vojt444/picoballoon/HW/picoballoon_v2/3D/SQ2337CES-T1_GE3.stp

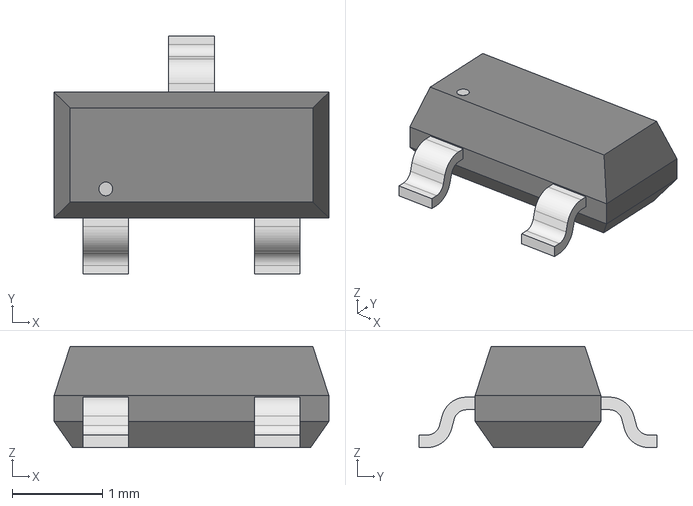
[picture p1: CAD file, 2025-04-12]
HW/picoballoon_v2/3D/SQ2337CES-T1_GE3.stp
3.05 x 2.64 x 1.12 mm
