vojt444/picoballoon/HW/picoballoon_v2/3D/CONMHF1-SMD-G-T.stp

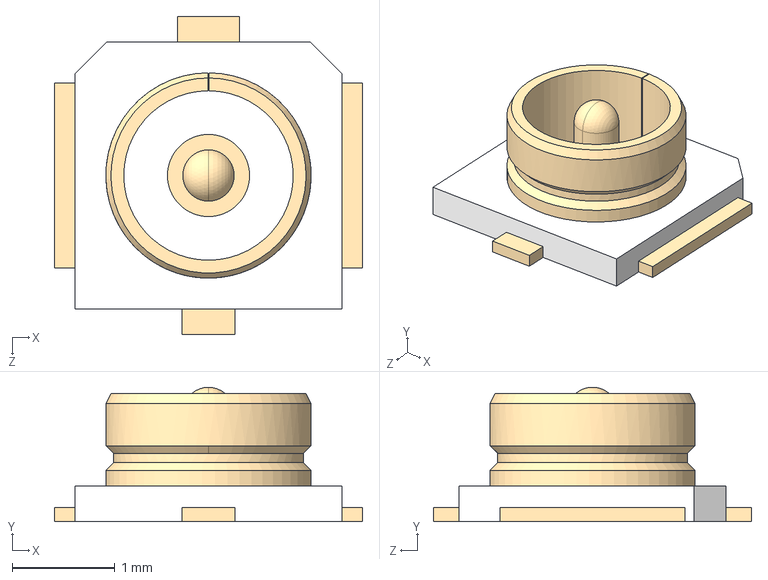
[picture p2: CAD file, 2025-04-12]
HW/picoballoon_v2/3D/CONMHF1-SMD-G-T.stp
3.00 x 1.31 x 3.10 mm
