vojt444/picoballoon/HW/picoballoon_v2/3D/RECE.20369.001E.01.stp

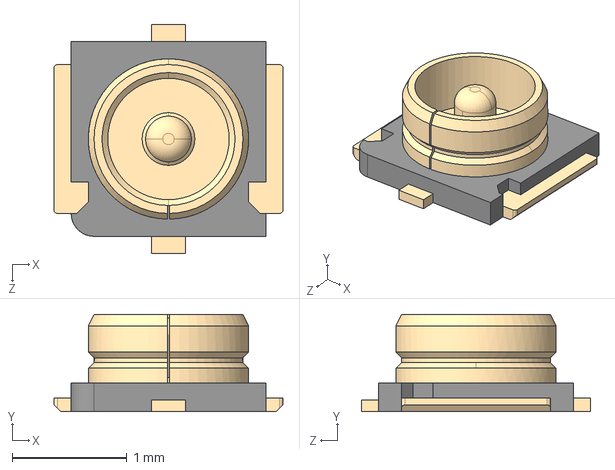
[picture p3: CAD file, 2024-12-13]
HW/picoballoon_v2/3D/RECE.20369.001E.01.stp
2.00 x 0.85 x 2.00 mm
