vojt444/picoballoon/HW/picoballoon_v2/3D/BLM21AG601SH1D.stp

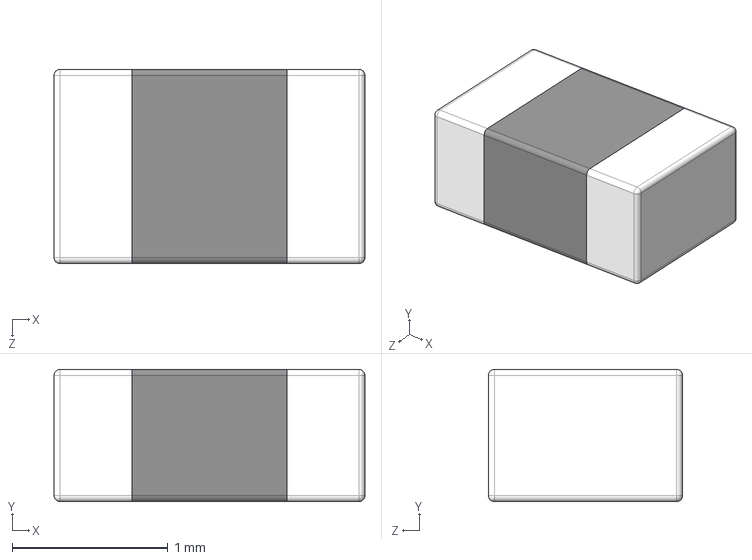
[picture p4: CAD file, 2024-12-07]
HW/picoballoon_v2/3D/BLM21AG601SH1D.stp
2.00 x 0.85 x 1.25 mm
