vojt444/picoballoon/HW/picoballoon_v2/3D/Si4461-C2A-GMR.stp

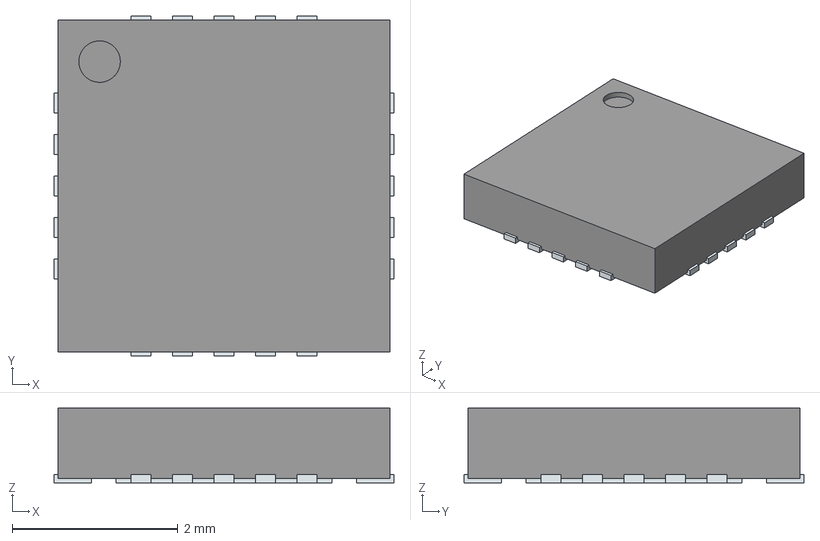
[picture p5: CAD file, 2024-12-07]
HW/picoballoon_v2/3D/Si4461-C2A-GMR.stp
4.10 x 4.10 x 0.9 mm
ThermalPin
PinsArrayLR
PinsArrayTB
