vojt444/picoballoon/HW/picoballoon_v2/3D/HTU21D.stp

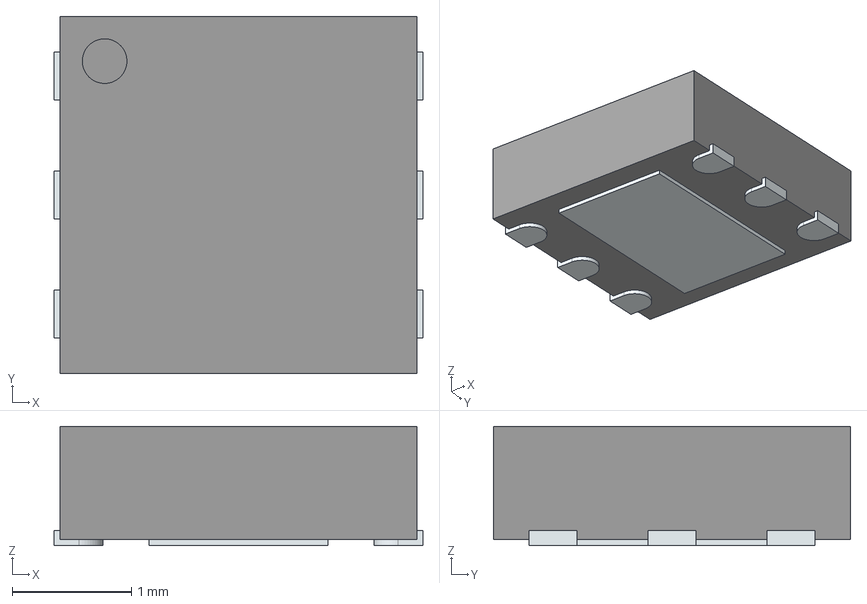
[picture p6: CAD file, 2024-12-07]
HW/picoballoon_v2/3D/HTU21D.stp
3.10 x 3.00 x 1.00 mm
ThermalPin
PinsArrayLR
