vojt444/picoballoon/HW/picoballoon_v2/3D/MPL3115A2ST1.stp

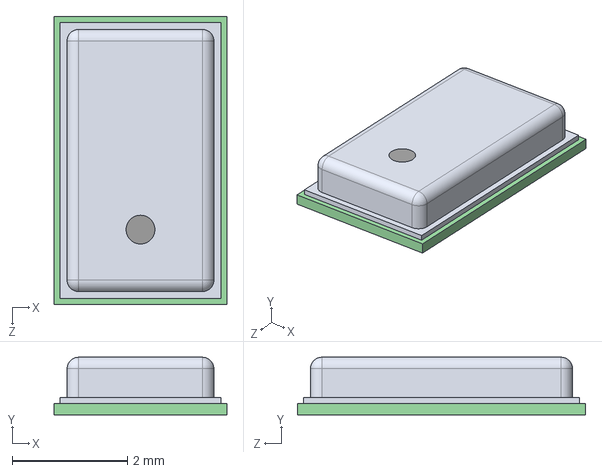
[picture p7: CAD file, 2024-12-07]
HW/picoballoon_v2/3D/MPL3115A2ST1.stp
3.00 x 1.00 x 5.00 mm
