vojt444/picoballoon/HW/picoballoon_v2/3D/MAX-M10M-00B.stp

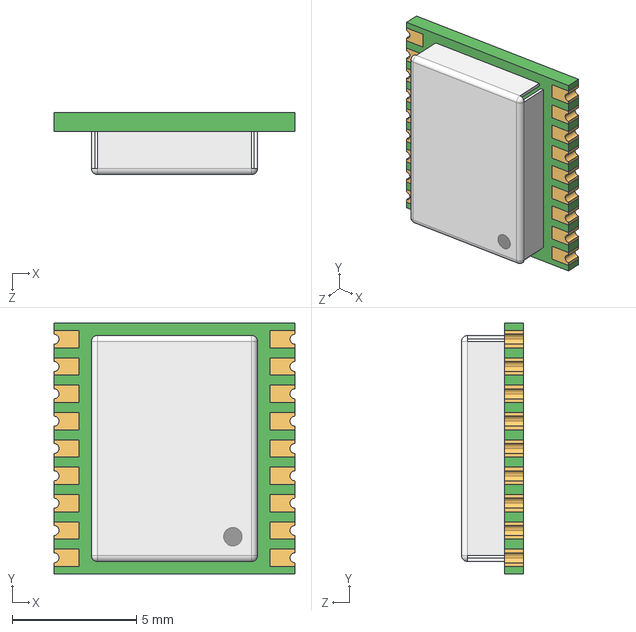
[picture p8: CAD file, 2024-12-07]
HW/picoballoon_v2/3D/MAX-M10M-00B.stp
9.70 x 10.1 x 2.50 mm
