vojt444/picoballoon/HW/picoballoon_v2/3D/TPS61097A-33DBVR.stp

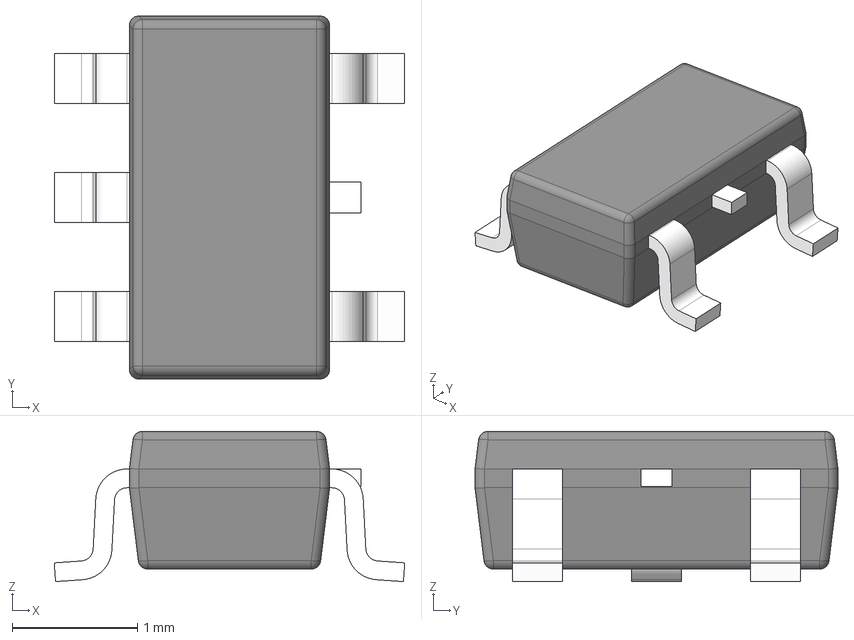
[picture p9: CAD file, 2024-12-07]
HW/picoballoon_v2/3D/TPS61097A-33DBVR.stp
2.80 x 2.90 x 1.20 mm
BODY-SOT
LEAD-SOT x 5
LEAD-DUMMY
