vojt444/picoballoon/HW/picoballoon_v2/picoballoon.kicad_pcb

## KiCad design HW/picoballoon_v2/picoballoon.kicad_pcb (2025-04-29)

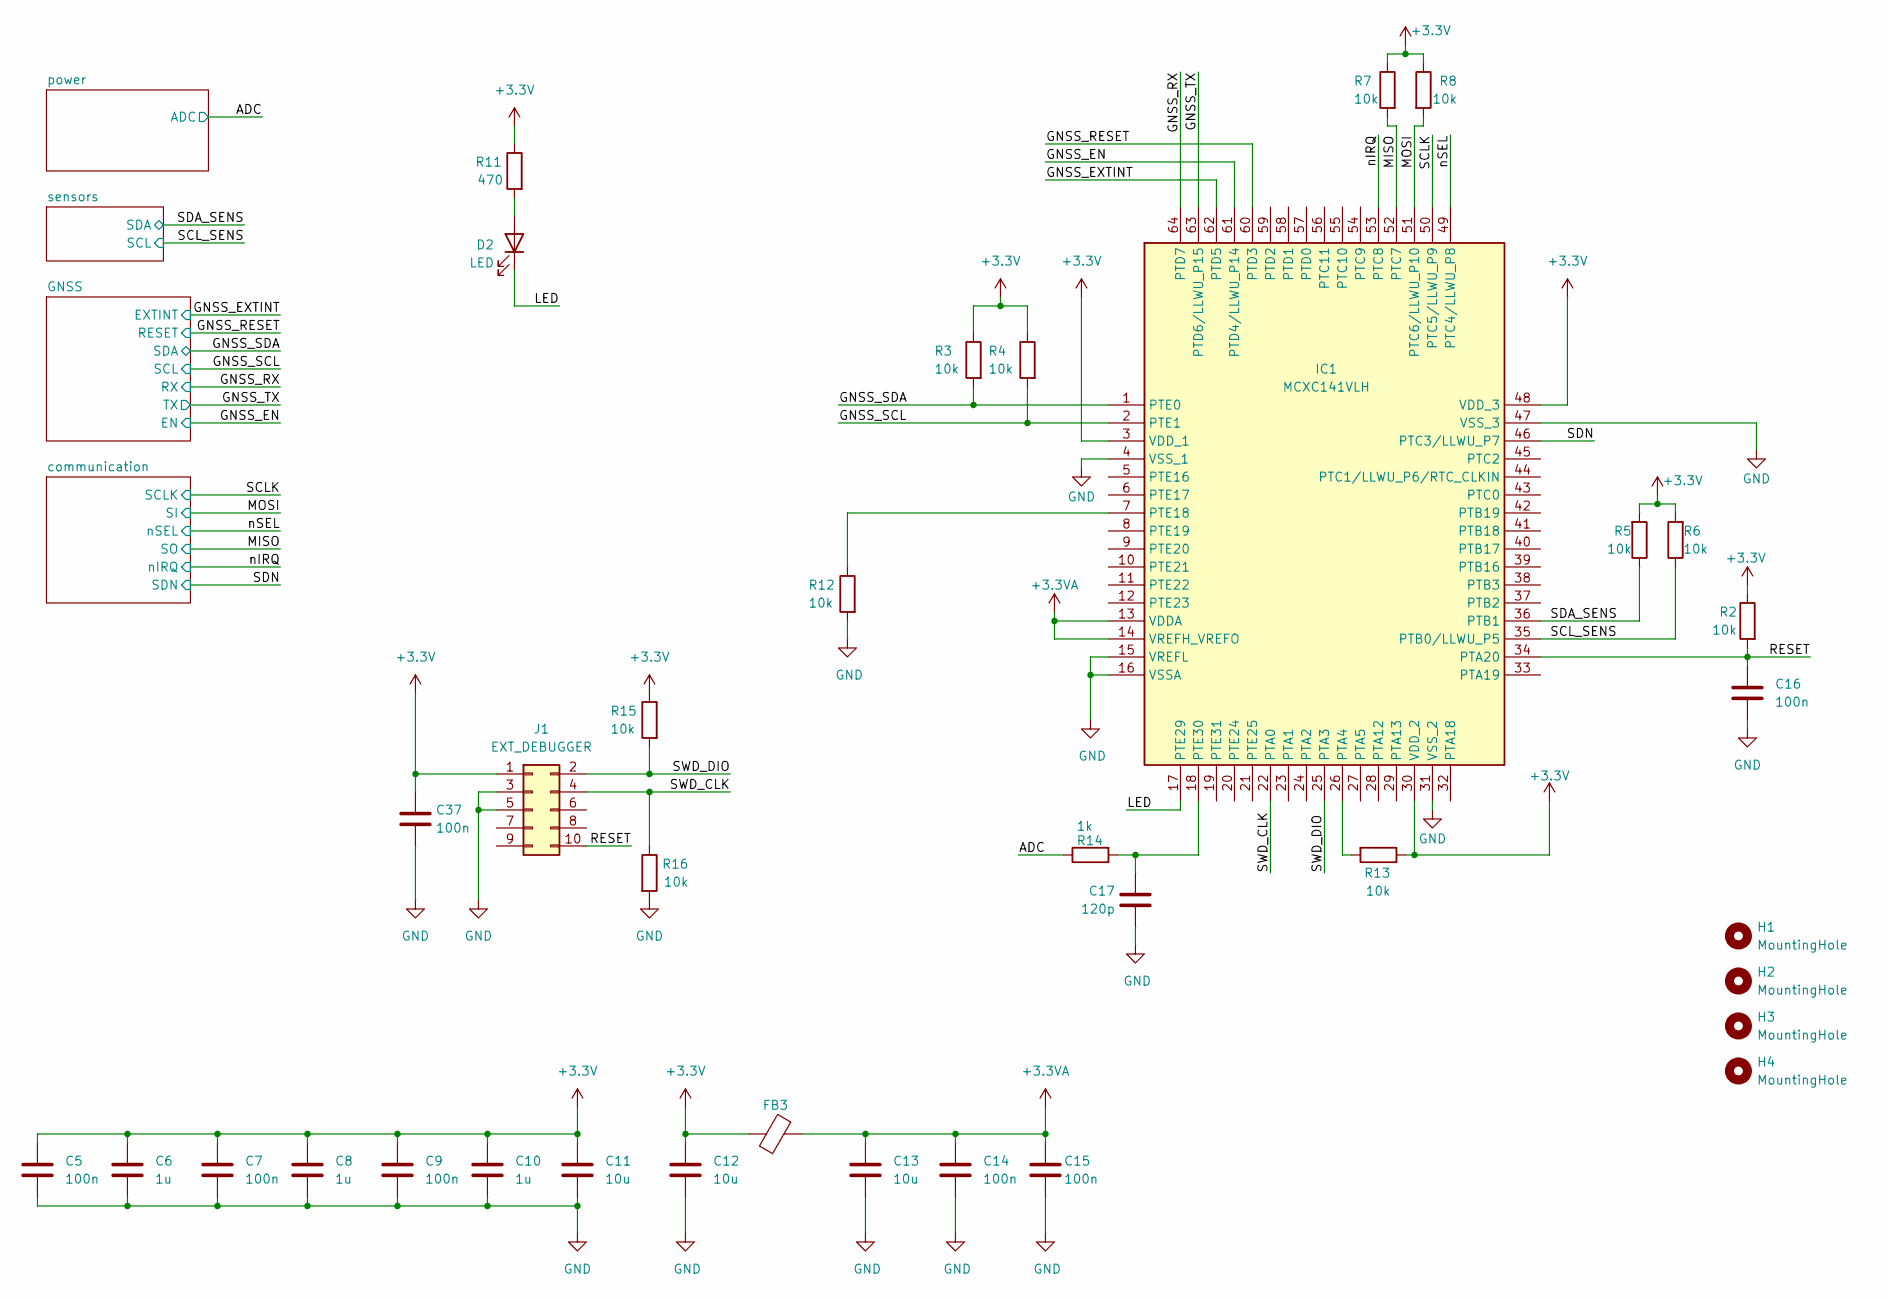
[picture p10: schematic picoballoon.kicad_sch, MCU]

Parts:
C5, C7, C9, C14, C15, C16, C37: 100n; C_0603_1608Metric_Pad1.08x0.95mm_HandSolder
C6, C8, C10: 1u; C_0603_1608Metric_Pad1.08x0.95mm_HandSolder
C11, C12, C13: 10u; C_0603_1608Metric_Pad1.08x0.95mm_HandSolder
C17: 120p; C_0603_1608Metric_Pad1.08x0.95mm_HandSolder
D2: LED; LED_0603_1608Metric_Pad1.05x0.95mm_HandSolder
FB3: FerriteBead; BLM21AG102BH1J
H1, H2, H3, H4: MountingHole; MountingHole_2.1mm
IC1: MCXC141VLH; LQFP-64-1EP_10x10mm_P0.5mm_EP5x5mm; Manufacturer_Part_Number MCXC141VLH; Mouser Part Number 771-MCXC141VLH
J1: EXT_DEBUGGER; PinHeader_2x05_P1.27mm_Vertical
R2, R3, R4, R5, R6, R7, R8, R12, R13, R15, R16: 10k; R_0603_1608Metric_Pad0.98x0.95mm_HandSolder
R11: 470; R_0603_1608Metric_Pad0.98x0.95mm_HandSolder
R14: 1k; R_0603_1608Metric_Pad0.98x0.95mm_HandSolder

Connections:
+3.3VA: C13.1, C14.1, C15.1, FB3.2, IC1.13 (VDDA), IC1.14 (VREFH_VREFO)
/ADC: R14.1; also elsewhere on the board
/GNSS_EN: IC1.61 (PTD4/LLWU_P14); also elsewhere on the board
/GNSS_EXTINT: IC1.62 (PTD5); also elsewhere on the board
/GNSS_RESET: IC1.60 (PTD3); also elsewhere on the board
/GNSS_RX: IC1.64 (PTD7); also elsewhere on the board
/GNSS_SCL: IC1.2 (PTE1), R4.2; also elsewhere on the board
/GNSS_SDA: IC1.1 (PTE0), R3.2; also elsewhere on the board
/GNSS_TX: IC1.63 (PTD6/LLWU_P15); also elsewhere on the board
/LED: D2.1 (K), IC1.17 (PTE29)
/MISO: IC1.52 (PTC7), R7.2; also elsewhere on the board
/MOSI: IC1.51 (PTC6/LLWU_P10), R8.2; also elsewhere on the board
/RESET: C16.1, IC1.34 (PTA20), J1.10, R2.2
/SCLK: IC1.50 (PTC5/LLWU_P9); also elsewhere on the board
/SCL_SENS: IC1.35 (PTB0/LLWU_P5), R6.1; also elsewhere on the board
/SDA_SENS: IC1.36 (PTB1), R5.1; also elsewhere on the board
/SDN: IC1.46 (PTC3/LLWU_P7); also elsewhere on the board
/SWD_CLK: IC1.22 (PTA0), J1.4, R16.1
/SWD_DIO: IC1.25 (PTA3), J1.2, R15.2
/nIRQ: IC1.53 (PTC8); also elsewhere on the board
/nSEL: IC1.49 (PTC4/LLWU_P8); also elsewhere on the board
unnamed: D2.2 (A), R11.2
unnamed: IC1.7 (PTE18), R12.1
unnamed: C17.1, IC1.18 (PTE30), R14.2

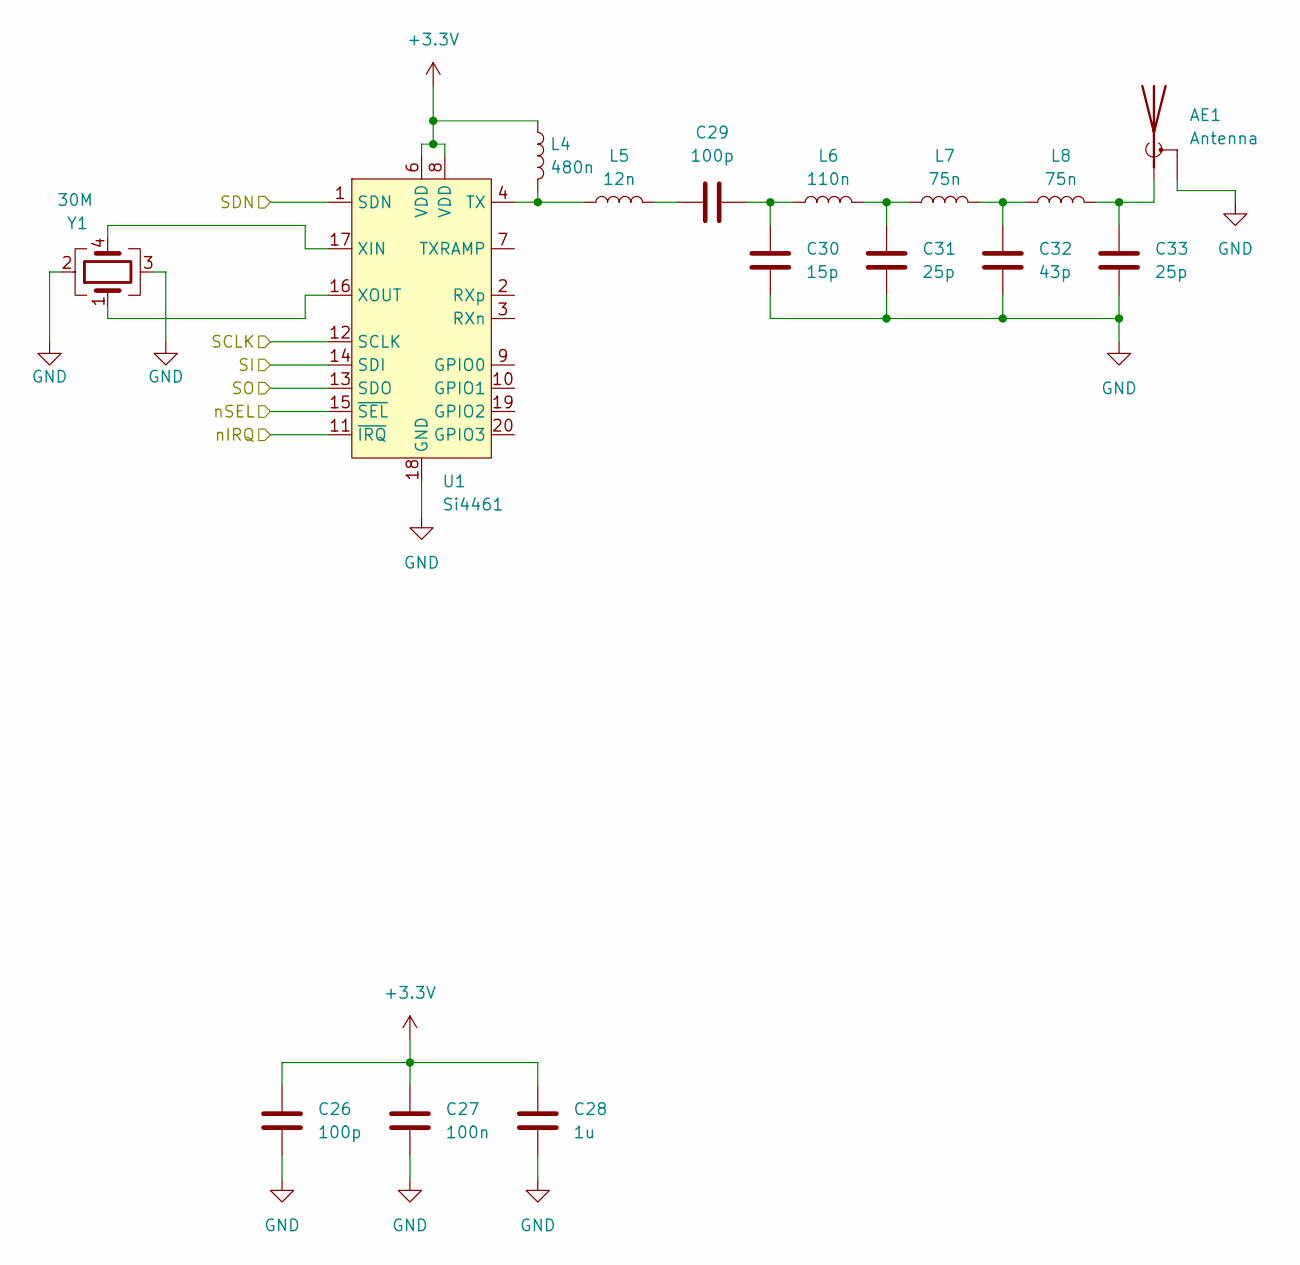
[picture p11: schematic communication.kicad_sch]

Parts:
AE1: Antenna; BNC_Connector_PCB
C26, C29: 100p; C_0603_1608Metric_Pad1.08x0.95mm_HandSolder
C27: 100n; C_0603_1608Metric_Pad1.08x0.95mm_HandSolder
C28: 1u; C_0603_1608Metric_Pad1.08x0.95mm_HandSolder
C30: 15p; C_0603_1608Metric_Pad1.08x0.95mm_HandSolder
C31, C33: 25p; C_0603_1608Metric_Pad1.08x0.95mm_HandSolder
C32: 43p; C_0603_1608Metric_Pad1.08x0.95mm_HandSolder
L4: 480n; L_0603_1608Metric_Pad1.05x0.95mm_HandSolder
L5: 12n; L_0603_1608Metric_Pad1.05x0.95mm_HandSolder
L6: 110n; L_0603_1608Metric_Pad1.05x0.95mm_HandSolder
L7, L8: 75n; L_0603_1608Metric_Pad1.05x0.95mm_HandSolder
U1: Si4461; QFN-20-1EP_4x4mm_P0.5mm_EP2.6x2.6mm_ThermalVias
Y1: 30M; ECS3002030BDUTR

Connections:
/MISO: U1.13 (SDO); also elsewhere on the board
/MOSI: U1.14 (SDI); also elsewhere on the board
/SCLK: U1.12 (SCLK); also elsewhere on the board
/SDN: U1.1 (SDN); also elsewhere on the board
/nIRQ: U1.11 (~IRQ); also elsewhere on the board
/nSEL: U1.15 (~SEL); also elsewhere on the board
unnamed: AE1.1 (A), C33.2, L8.2
unnamed: C29.1, L5.2
unnamed: C29.2, C30.2, L6.1
unnamed: C31.2, L6.2, L7.1
unnamed: C32.2, L7.2, L8.1
unnamed: L4.2, L5.1, U1.4 (TX)
unnamed: U1.17 (XIN), Y1.4
unnamed: U1.16 (XOUT), Y1.1

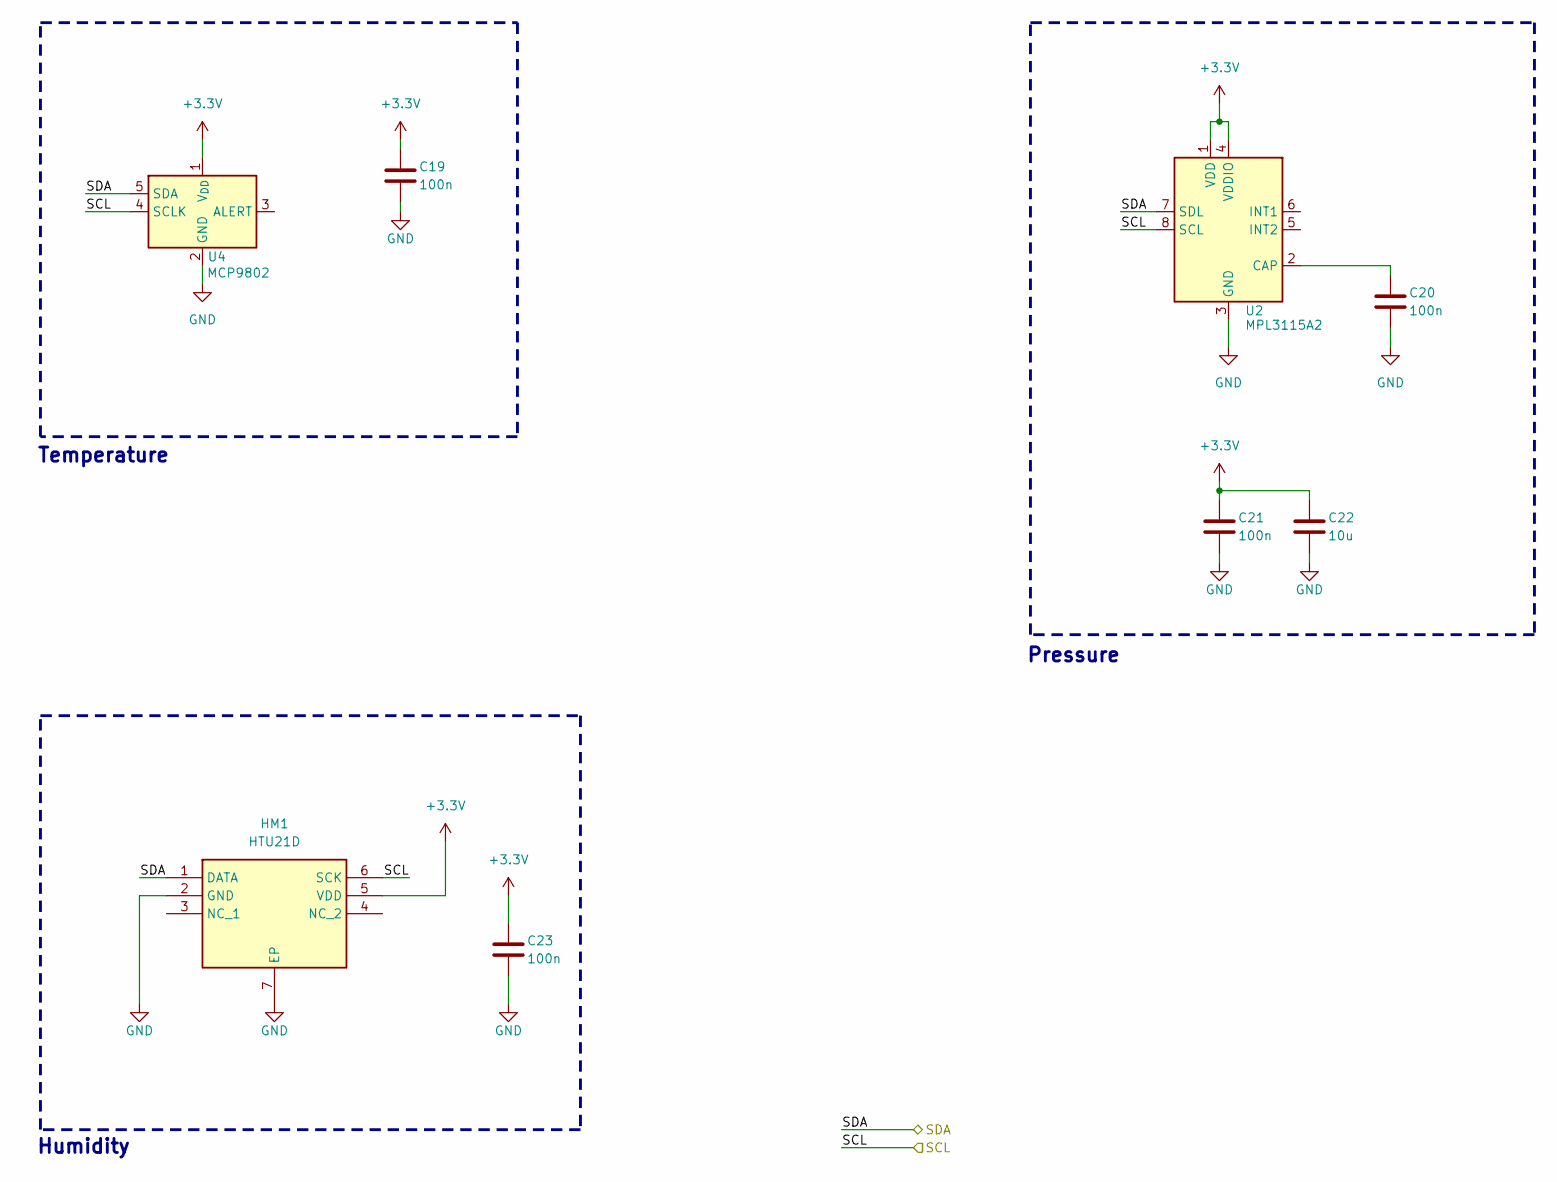
[picture p12: schematic sensors.kicad_sch]

Parts:
C19, C20, C21, C23: 100n; C_0603_1608Metric_Pad1.08x0.95mm_HandSolder
C22: 10u; C_0603_1608Metric_Pad1.08x0.95mm_HandSolder
HM1: HTU21D; SON100P300X300X100-7N-D; Mouser Part Number 824-HTU21D
U2: MPL3115A2; NXP_LGA-8_3x5mm_P1.25mm_H1.1mm
U4: MCP9802; SOT-23-5

Connections:
/SCL_SENS: HM1.6 (SCK), U2.8 (SCL), U4.4 (SCLK); also elsewhere on the board
/SDA_SENS: HM1.1 (DATA), U2.7 (SDL), U4.5 (SDA); also elsewhere on the board
unnamed: C20.1, U2.2 (CAP)

Notes on the sheet:
Pressure
Humidity
Temperature

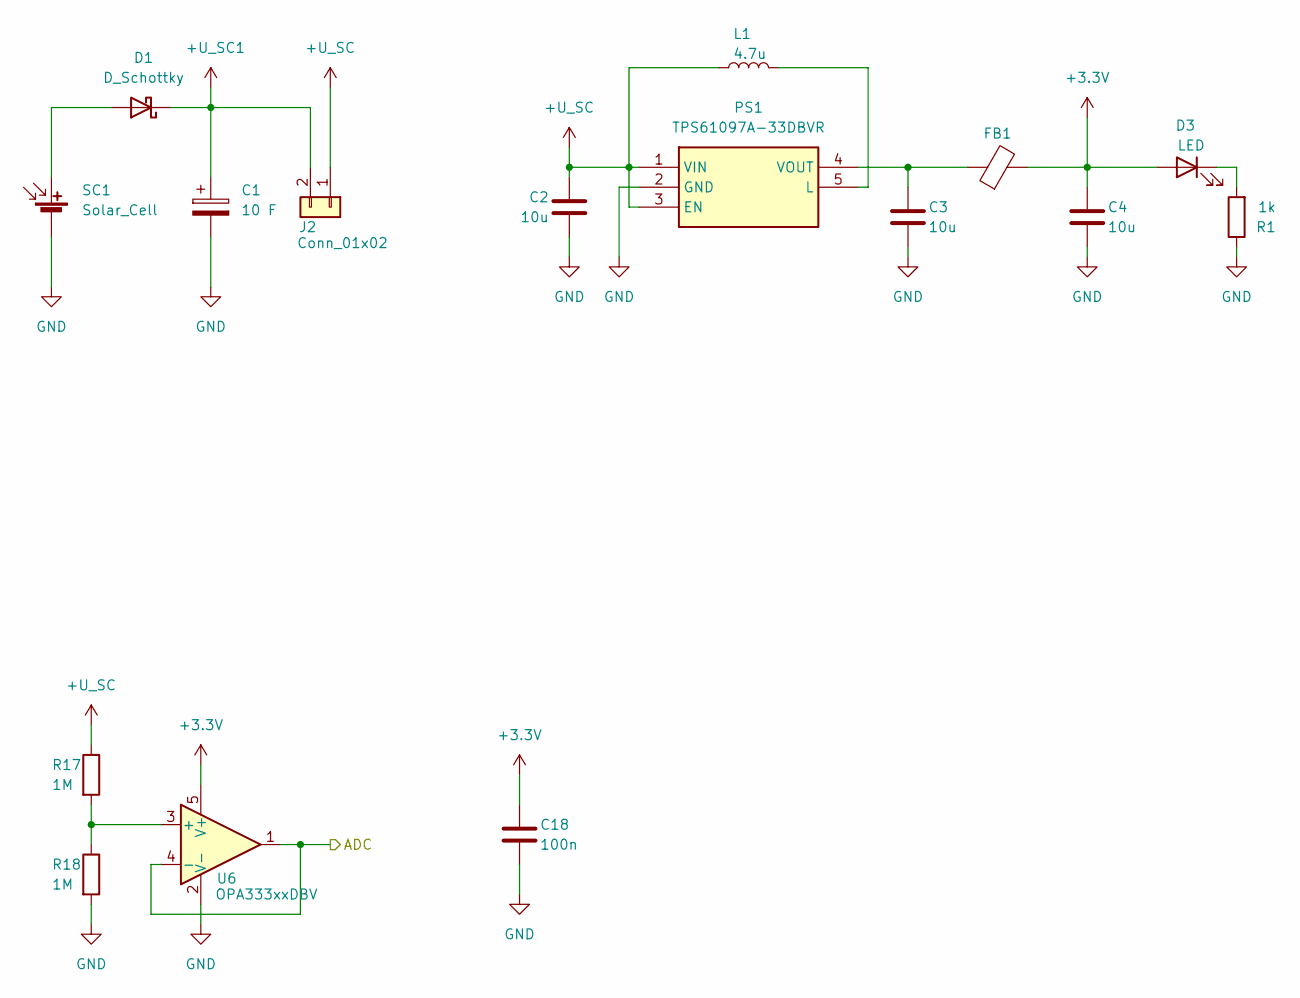
[picture p13: schematic power.kicad_sch]

Parts:
C1: 10 F; Supercap_7.5mm
C2, C3, C4: 10u; C_0603_1608Metric_Pad1.08x0.95mm_HandSolder
C18: 100n; C_0603_1608Metric_Pad1.08x0.95mm_HandSolder
D1: D_Schottky; Nexperia_CFP3_SOD-123W
D3: LED; LED_0603_1608Metric_Pad1.05x0.95mm_HandSolder
FB1: FerriteBead; BLM21AG102BH1J
J2: Conn_01x02; PinHeader_1x02_P2.54mm_Vertical
L1: 4.7u; L_0603_1608Metric_Pad1.05x0.95mm_HandSolder
PS1: TPS61097A-33DBVR; SOT95P280X145-5N; Mouser Part Number 595-TPS61097A-33DBVR
R1: 1k; R_0603_1608Metric_Pad0.98x0.95mm_HandSolder
R17, R18: 1M; R_0603_1608Metric_Pad0.98x0.95mm_HandSolder
SC1: Solar_Cell; PinHeader_1x02_P2.54mm_Vertical
U6: OPA333xxDBV; SOT-23-5

Connections:
+U_SC: C2.1, J2.1, L1.1, PS1.1 (VIN), PS1.3 (EN), R17.1
+U_SC1: C1.1, D1.1 (K), J2.2
/ADC: U6.1, U6.4 (-); also elsewhere on the board
unnamed: D1.2 (A), SC1.1 (+)
unnamed: D3.1 (K), R1.2
unnamed: L1.2, PS1.5 (L)
unnamed: C3.1, FB1.1, PS1.4 (VOUT)
unnamed: R17.2, R18.1, U6.3 (+)

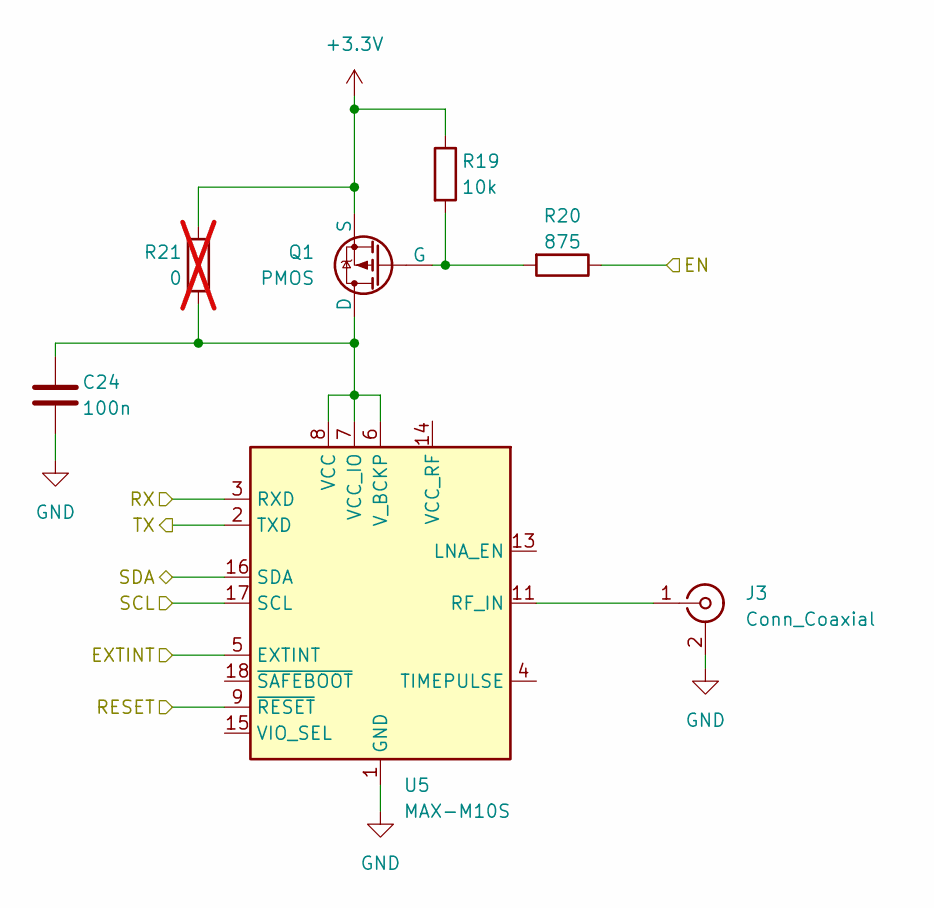
[picture p14: schematic GNSS.kicad_sch]

Parts:
C24: 100n; C_0603_1608Metric_Pad1.08x0.95mm_HandSolder
J3: Conn_Coaxial; U.FL_Molex_MCRF_73412-0110_Vertical
Q1: PMOS; SOT95P237X112-3N
R19: 10k; R_0603_1608Metric_Pad0.98x0.95mm_HandSolder
R20: 875; R_0603_1608Metric_Pad0.98x0.95mm_HandSolder
R21: 0; R_0603_1608Metric_Pad0.98x0.95mm_HandSolder; not fitted
U5: MAX-M10S; ublox_MAX

Connections:
/GNSS_EN: R20.1; also elsewhere on the board
/GNSS_EXTINT: U5.5 (EXTINT); also elsewhere on the board
/GNSS_RESET: U5.9 (~RESET); also elsewhere on the board
/GNSS_RX: U5.3 (RXD); also elsewhere on the board
/GNSS_SCL: U5.17 (SCL); also elsewhere on the board
/GNSS_SDA: U5.16 (SDA); also elsewhere on the board
/GNSS_TX: U5.2 (TXD); also elsewhere on the board
unnamed: J3.1 (In), U5.11 (RF_IN)
unnamed: C24.1, Q1.1 (D), R21.2, U5.6 (V_BCKP), U5.7 (VCC_IO), U5.8 (VCC)

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
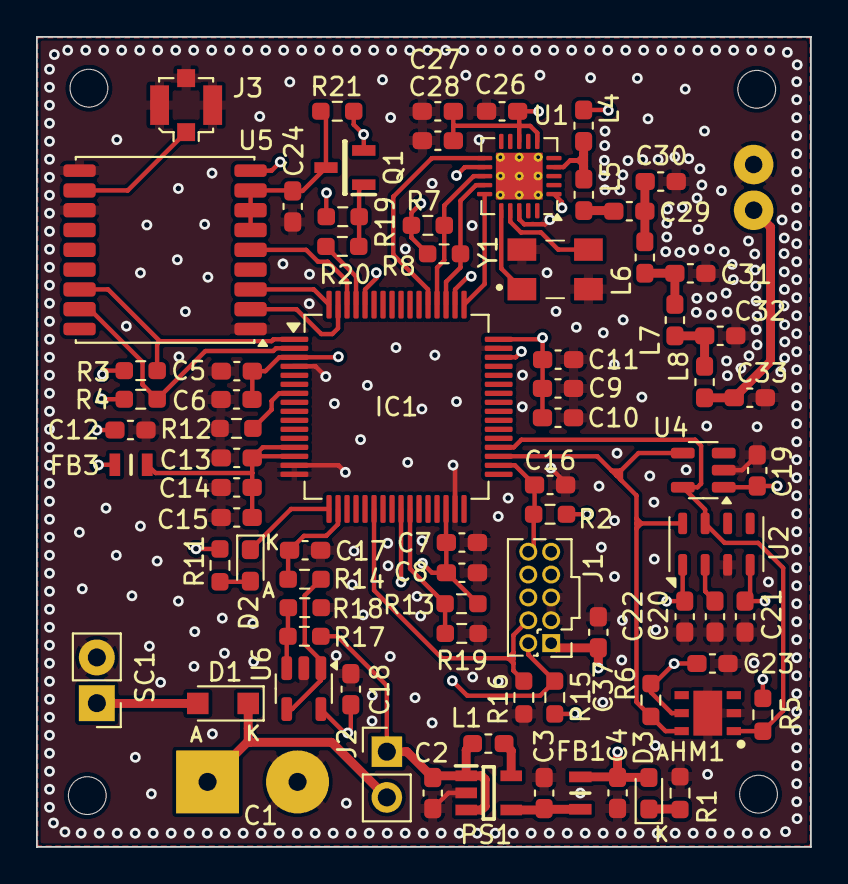
[picture p15: board picoballoon.kicad_pcb from above]

Board: 4 copper layers, 43.0 x 45.0 mm, 83 parts (0 on the bottom side), 46 nets.

Other parts of the board:
R19#2: 10k; R_0603_1608Metric_Pad0.98x0.95mm_HandSolder
