vojt444/picoballoon/HW/aprs_test_board/aprs_test_board.kicad_pcb

## KiCad design HW/aprs_test_board/aprs_test_board.kicad_pcb (2025-02-13)

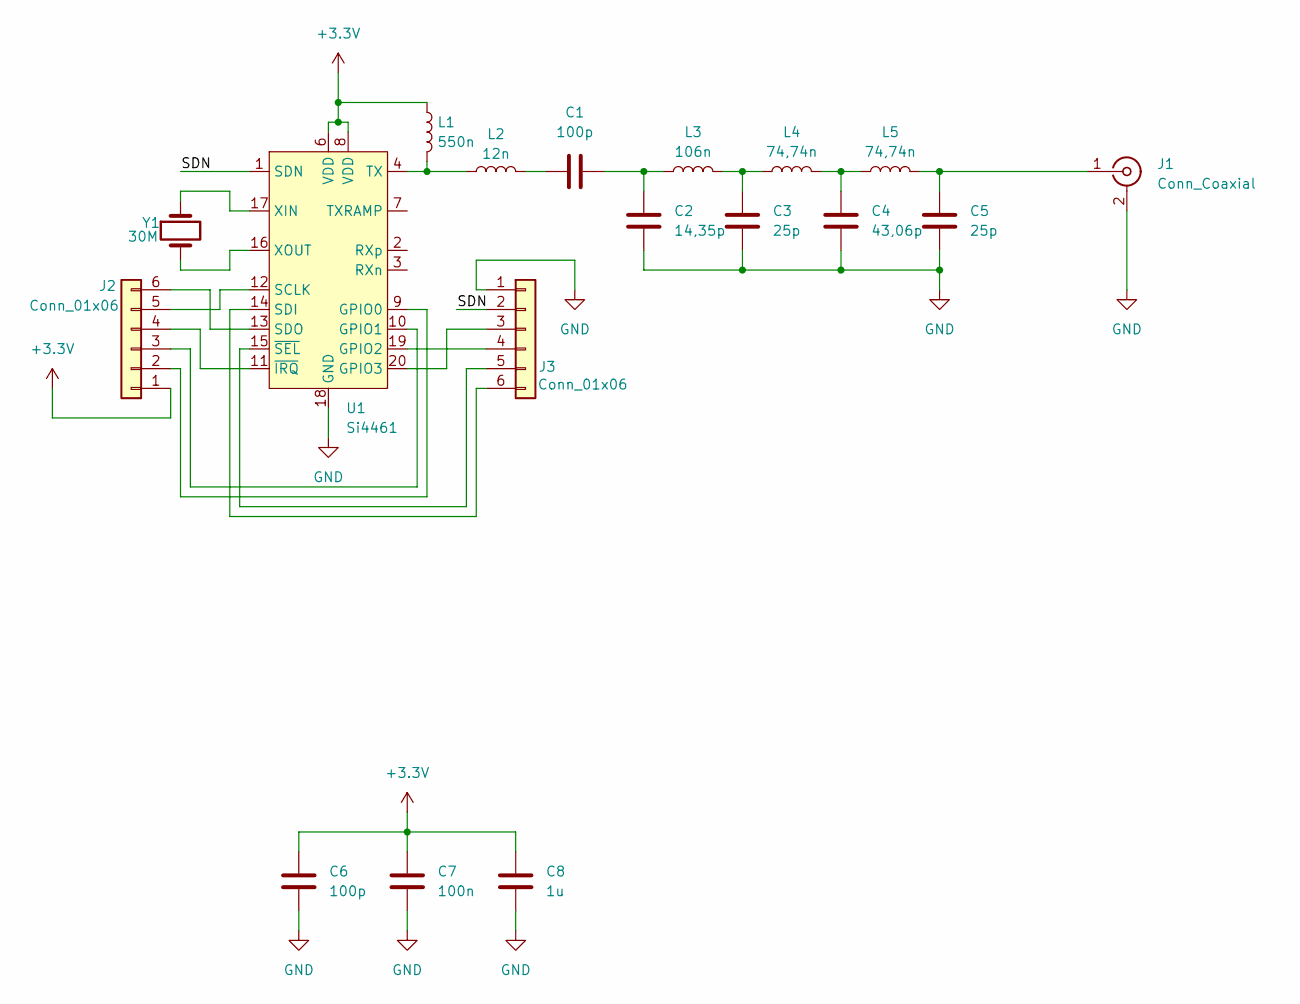
[picture p16: schematic aprs_test_board.kicad_sch, APRS test board]

Parts:
C1, C6: 100p; C_0805_2012Metric_Pad1.18x1.45mm_HandSolder
C2: 14,35p; C_0805_2012Metric_Pad1.18x1.45mm_HandSolder
C3, C5: 25p; C_0805_2012Metric_Pad1.18x1.45mm_HandSolder
C4: 43,06p; C_0805_2012Metric_Pad1.18x1.45mm_HandSolder
C7: 100n; C_0805_2012Metric_Pad1.18x1.45mm_HandSolder
C8: 1u; C_0805_2012Metric_Pad1.18x1.45mm_HandSolder
J1: Conn_Coaxial; BNC_Connector_PCB
J2, J3: Conn_01x06; PinHeader_1x06_P2.54mm_Vertical
L1: 550n; L_0805_2012Metric_Pad1.15x1.40mm_HandSolder
L2: 12n; L_0805_2012Metric_Pad1.15x1.40mm_HandSolder
L3: 106n; L_0805_2012Metric_Pad1.15x1.40mm_HandSolder
L4, L5: 74,74n; L_0805_2012Metric_Pad1.15x1.40mm_HandSolder
U1: Si4461; QFN-20-1EP_4x4mm_P0.5mm_EP2.6x2.6mm_ThermalVias
Y1: 30M; ECS3002030BDUTR

Connections:
+3.3V: C6.1, C7.1, C8.1, J2.1, L1.1, U1.6 (VDD), U1.8 (VDD)
/SDN: J3.2, U1.1 (SDN)
GND: C2.1, C3.1, C4.1, C5.1, C6.2, C7.2, C8.2, J1.2 (Ext), J3.1, U1.18 (GND), U1.21 (GND), Y1.3, Y1.4
unnamed: C1.1, L2.2
unnamed: C1.2, C2.2, L3.1
unnamed: C3.2, L3.2, L4.1
unnamed: C4.2, L4.2, L5.1
unnamed: C5.2, J1.1 (In), L5.2
unnamed: J2.2, U1.9 (GPIO0)
unnamed: J2.3, U1.10 (GPIO1)
unnamed: J2.4, U1.11 (~IRQ)
unnamed: J2.5, U1.12 (SCLK)
unnamed: J2.6, U1.13 (SDO)
unnamed: J3.3, U1.20 (GPIO3)
unnamed: J3.4, U1.19 (GPIO2)
unnamed: J3.5, U1.15 (~SEL)
unnamed: J3.6, U1.14 (SDI)
unnamed: L1.2, L2.1, U1.4 (TX)
unnamed: U1.17 (XIN), Y1.1
unnamed: U1.16 (XOUT), Y1.2

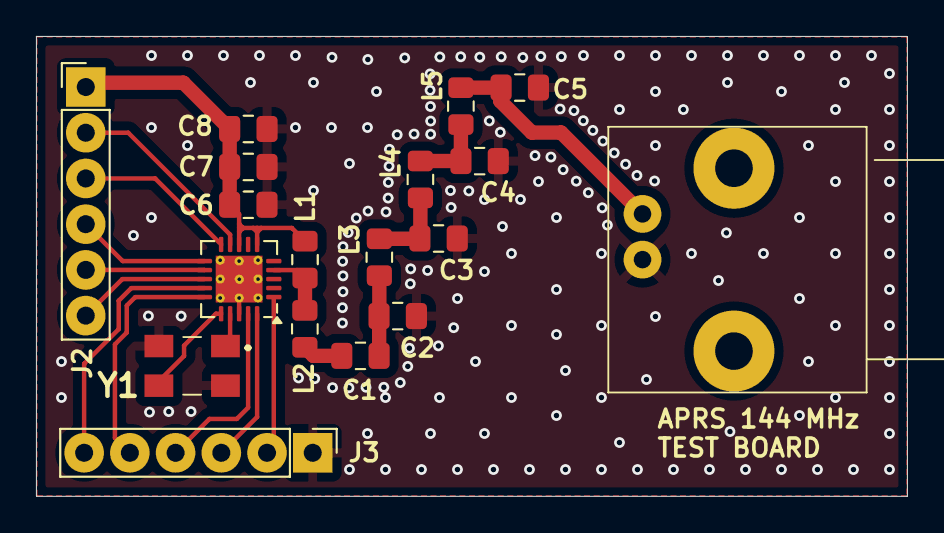
[picture p17: board aprs_test_board.kicad_pcb from above]

Board: 2 copper layers, 48.4 x 25.5 mm, 18 parts (0 on the bottom side), 20 nets.
