vojt444/picoballoon/HW/picoballoon/picoballoon_mcxl.kicad_pcb

## KiCad design HW/picoballoon/picoballoon_mcxl.kicad_pcb (2024-12-27, an earlier design)

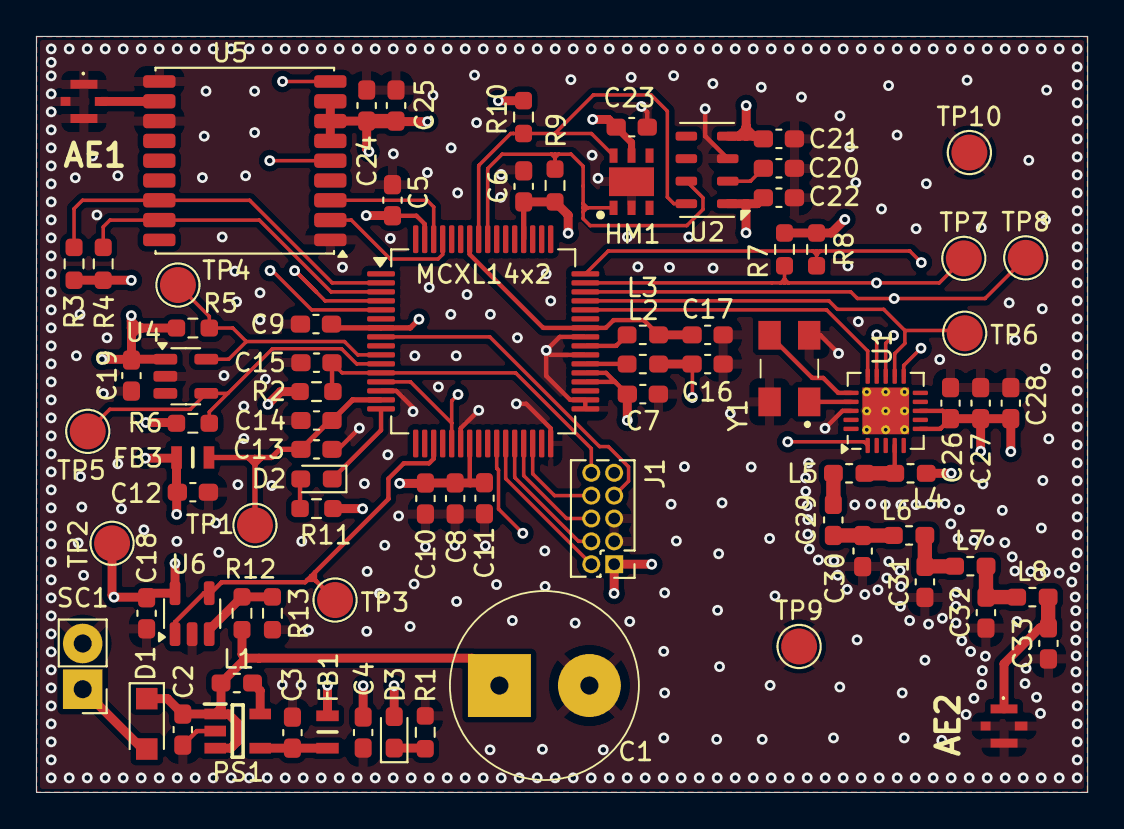
[picture p18: board picoballoon_mcxl.kicad_pcb from above]

Board: 4 copper layers, 58.4 x 42.0 mm, 82 parts (0 on the bottom side), 48 nets.

Parts:
AE1, AE2: Antenna; RECE20369001E01
C1: 10 F; Supercap_7.5mm
C2, C3, C4, C11, C12, C13, C22: 10u; C_0603_1608Metric_Pad1.08x0.95mm_HandSolder
C5, C6, C7, C8, C9, C10, C14, C15, C18, C19, C20, C21, C23, C24, C25, C27: 100n; C_0603_1608Metric_Pad1.08x0.95mm_HandSolder
C16, C17: 4.7u; C_0603_1608Metric_Pad1.08x0.95mm_HandSolder
C26, C29: 100p; C_0603_1608Metric_Pad1.08x0.95mm_HandSolder
C28: 1u; C_0603_1608Metric_Pad1.08x0.95mm_HandSolder
C30: 14,35p; C_0603_1608Metric_Pad1.08x0.95mm_HandSolder
C31, C33: 25p; C_0603_1608Metric_Pad1.08x0.95mm_HandSolder
C32: 43,06p; C_0603_1608Metric_Pad1.08x0.95mm_HandSolder
D1: D_Schottky; Nexperia_CFP3_SOD-123W
D2, D3: LED; LED_0603_1608Metric_Pad1.05x0.95mm_HandSolder
FB1, FB3: FerriteBead; BLM21AG102BH1J
HM1: HTU21D; SON100P300X300X100-7N-D
J1: EXT_DEBUGGER; PinHeader_2x05_P1.27mm_Vertical
L1, L2, L3: 4.7u; L_0603_1608Metric_Pad1.05x0.95mm_HandSolder
L4: 552n; L_0603_1608Metric_Pad1.05x0.95mm_HandSolder
L5: 12n; L_0603_1608Metric_Pad1.05x0.95mm_HandSolder
L6: 106n; L_0603_1608Metric_Pad1.05x0.95mm_HandSolder
L7, L8: 74,74n; L_0603_1608Metric_Pad1.05x0.95mm_HandSolder
MCXL14x2: LQFP-64-1EP_10x10mm_P0.5mm_EP5x5mm
PS1: TPS61097A-33DBVR; SOT95P280X145-5N
R1: 1k; R_0603_1608Metric_Pad0.98x0.95mm_HandSolder
R2, R3, R4, R5, R6, R7, R8, R9, R10: 10k; R_0603_1608Metric_Pad0.98x0.95mm_HandSolder
R11: 300; R_0603_1608Metric_Pad0.98x0.95mm_HandSolder
R12, R13: 1M; R_0603_1608Metric_Pad0.98x0.95mm_HandSolder
SC1: Solar_Cell; PinHeader_1x02_P2.54mm_Vertical
TP1: +3.3VA_TP; TestPoint_Pad_D2.0mm
TP2: +3.3V_TP; TestPoint_Pad_D2.0mm
TP3: ADC; TestPoint_Pad_D2.0mm
TP4: SDA_TEMP; TestPoint_Pad_D2.0mm
TP5: SCL_TEMP; TestPoint_Pad_D2.0mm
TP6: SCLK; TestPoint_Pad_D2.0mm
TP7: MOSI; TestPoint_Pad_D2.0mm
TP8: MISO; TestPoint_Pad_D2.0mm
TP9, TP10: GND; TestPoint_Pad_D2.0mm
U1: Si4461; QFN-20-1EP_4x4mm_P0.5mm_EP2.6x2.6mm_ThermalVias
U2: MPL3115A2; NXP_LGA-8_3x5mm_P1.25mm_H1.1mm
U4: MCP9802; SOT-23-5
U5: MAX-M10S; ublox_MAX
U6: OPA333xxDBV; SOT-23-5
Y1: 30M; ECS3002030BDUTR

Connections:
+3.3V: C4.1, C5.1, C6.1, C7.1, C8.1, C9.1, C10.1, C11.1, C12.1, C18.1, C19.1, C21.1, C22.1, C23.1, C24.1, C25.1, C26.1, C27.1, C28.1, D3.2 (A), FB1.2, FB3.1, HM1.5 (VDD), J1.1, L4.1, MCXL14x2.7 (VDD), MCXL14x2.23 (VDD), MCXL14x2.36 (VDD), MCXL14x2.37 (VDD_BAT), MCXL14x2.52 (VDD), MCXL14x2.63 (VDD), R2.1, R3.1, R4.1, R5.1, R6.1, R7.1, R8.1, R9.1, R10.1, R11.1, TP2.1, U1.6 (VDD), U1.8 (VDD), U2.1 (VDD), U2.4 (VDDIO), U4.1 (V_{DD}), U5.6 (V_BCKP), U5.7 (VCC_IO), U5.8 (VCC), U6.5 (V+)
+3.3VA: C13.1, C14.1, FB3.2, MCXL14x2.15 (VDD_ANA), TP1.1
+U_SC: C1.1, C2.1, D1.1 (K), L1.1, PS1.1 (VIN), PS1.3 (EN), R12.1
/ADC: MCXL14x2.19 (P0_23), TP3.1, U6.1, U6.4 (-)
/GNSS_EXTINT: MCXL14x2.5 (P0_13), U5.5 (EXTINT)
/GNSS_RESET: MCXL14x2.4 (P0_12), U5.9 (~RESET)
/GNSS_RX: MCXL14x2.62 (P0_1), U5.3 (RXD)
/GNSS_SCL: MCXL14x2.3 (P0_5), R4.2, U5.17 (SCL)
/GNSS_SDA: MCXL14x2.2 (P0_4), R3.2, U5.16 (SDA)
/GNSS_TX: MCXL14x2.61 (P0_0), U5.2 (TXD)
/ISP: J1.7, MCXL14x2.8 (P0_15)
/LED: D2.1 (K), MCXL14x2.16 (P0_20)
/MISO: MCXL14x2.46 (P1_2), TP8.1, U1.13 (SDO)
/MOSI: MCXL14x2.47 (P1_3), R7.2, TP7.1, U1.14 (SDI)
/RESET: C15.1, J1.10, MCXL14x2.12 (RESET_B), R2.2
/SCLK: MCXL14x2.45 (P1_1), TP6.1, U1.12 (SCLK)
/SCL_SENS: HM1.6 (SCK), MCXL14x2.57 (P1_20), R10.2, U2.8 (SCL)
/SCL_TEMP: MCXL14x2.11 (P0_19), R6.2, TP5.1, U4.4 (SCLK)
/SDA_SENS: HM1.1 (DATA), MCXL14x2.56 (P1_19), R9.2, U2.7 (SDL)
/SDA_TEMP: MCXL14x2.10 (P0_18), R5.2, TP4.1, U4.5 (SDA)
/SDN: MCXL14x2.26 (P2_8), U1.1 (SDN)
/VDD_CORE: C16.1, L2.2, MCXL14x2.13 (VDD_CORE), MCXL14x2.21 (VDD_CORE)
/VDD_CORE_1POV: C17.1, L3.2, MCXL14x2.42 (VDD_CORE_1P0V), MCXL14x2.58 (VDD_CORE_1P0V)
/nIRQ: MCXL14x2.48 (P1_12), R8.2, U1.11 (~IRQ)
/nSEL: MCXL14x2.44 (P1_0), U1.15 (~SEL)
GND: AE1.2, AE1.3, AE1.4, AE2.2, AE2.3, AE2.4, C1.2, C2.2, C3.2, C4.2, C5.2, C6.2, C7.2, C8.2, C9.2, C10.2, C11.2, C12.2, C13.2, C14.2, C15.2, C16.2, C17.2, C18.2, C19.2, C20.2, C21.2, C22.2, C23.2, C24.2, C25.2, C26.2, C27.2, C28.2, C30.1, C31.1, C32.1, C33.1, HM1.2 (GND), HM1.7 (EP), J1.3, J1.5, MCXL14x2.14 (VSS), MCXL14x2.22 (VSS), MCXL14x2.32 (ATESTMODE_2), MCXL14x2.33 (ATESTMODE_1), MCXL14x2.34 (ATESTMODE_0), MCXL14x2.39 (VSS_DCDC), MCXL14x2.41 (VSS), PS1.2 (GND), R1.1, R13.2, SC1.2 (-), TP9.1, TP10.1, U1.18 (GND), U1.21 (GND), U2.3 (GND), U4.2 (GND), U5.1 (GND), U5.10 (GND), U5.12 (GND), U6.2 (V-), Y1.3, Y1.4
unnamed: AE1.1 (A), U5.11 (RF_IN)
unnamed: AE2.1 (A), C33.2, L8.2
unnamed: C29.1, L5.2
unnamed: C29.2, C30.2, L6.1
unnamed: C31.2, L6.2, L7.1
unnamed: C32.2, L7.2, L8.1
unnamed: D1.2 (A), SC1.1 (+)
unnamed: D2.2 (A), R11.2
unnamed: D3.1 (K), R1.2
unnamed: J1.2, MCXL14x2.27 (P2_4/SWDIO/TSM)
unnamed: J1.4, MCXL14x2.28 (P2_5/SWCLK/TDO)
unnamed: J1.6, MCXL14x2.29 (P2_6/SWO/TDO)
unnamed: J1.8, MCXL14x2.30 (P2_7/TDI)
unnamed: L2.1, MCXL14x2.38 (DCDC_LX)
unnamed: L3.1, MCXL14x2.40 (DCDC_LX_1P0)
unnamed: L1.2, PS1.5 (L)
unnamed: C3.1, FB1.1, PS1.4 (VOUT)
unnamed: L4.2, L5.1, U1.4 (TX)
unnamed: U1.17 (XIN), Y1.1
unnamed: U1.16 (XOUT), Y1.2
unnamed: C20.1, U2.2 (CAP)
unnamed: R12.2, R13.1, U6.3 (+)
