vojt444/picoballoon/SW/picoballoon_v1/MCXC242_Project/device/periph1/PERI_FGPIO.h

/*
** ###################################################################
**     Processors:          MCXC141VFM
**                          MCXC141VLH
**                          MCXC142VFM
**                          MCXC242VFM
**                          MCXC242VLH
**
**     Version:             rev. 1.6, 2016-06-24
**     Build:               b240705
**
**     Abstract:
**         CMSIS Peripheral Access Layer for FGPIO
**
**     Copyright 1997-2016 Freescale Semiconductor, Inc.
**     Copyright 2016-2024 NXP
**     SPDX-License-Identifier: BSD-3-Clause
**
**     http:                 www.nxp.com
**     mail:                 support@nxp.com
**
**     Revisions:
**     - rev. 1.0 (2014-05-12)
**         Initial version.
**     - rev. 1.1 (2014-07-10)
**         UART0 - UART0 module renamed to UART2.
**     - rev. 1.2 (2014-08-12)
**         CRC - CRC register renamed to DATA.
**     - rev. 1.3 (2014-09-02)
**         USB - USB0_CTL0 was renamed to USB0_OTGCTL register.
**         USB - USB0_CTL1 was renamed to USB0_CTL register.
**         USB - Two new bitfields (STOP_ACK_DLY_EN, AHB_DLY_EN) was added to the USB0_KEEP_ALIVE_CTRL register.
**     - rev. 1.4 (2014-09-22)
**         FLEXIO - Offsets of the SHIFTBUFBIS registers were interchanged with offsets of the SHIFTBUFBBS registers.
**         SIM - Changed bitfield value MCGIRCLK to LIRC_CLK of bitfield CLKOUTSEL in SOPT2 register.
**         SIM - Removed bitfield DIEID in SDID register.
**         UART2 - Removed ED register.
**         UART2 - Removed MODEM register.
**         UART2 - Removed IR register.
**         UART2 - Removed PFIFO register.
**         UART2 - Removed CFIFO register.
**         UART2 - Removed SFIFO register.
**         UART2 - Removed TWFIFO register.
**         UART2 - Removed TCFIFO register.
**         UART2 - Removed RWFIFO register.
**         UART2 - Removed RCFIFO register.
**         USB - Removed bitfield REG_EN in CLK_RECOVER_IRC_EN register.
**         USB - Renamed USBEN bitfield of USB0_CTL was renamed to USBENSOFEN.
**     - rev. 1.5 (2016-02-02)
**         FGPIO - Add FGPIO registers.
**     - rev. 1.6 (2016-06-24)
**         USB - OTGCTL register was removed.
**         USB - Bit RESUME was added in CTL register.
**
** ###################################################################
*/

/*!
 * @file FGPIO.h
 * @version 1.6
 * @date 2016-06-24
 * @brief CMSIS Peripheral Access Layer for FGPIO
 *
 * CMSIS Peripheral Access Layer for FGPIO
 */

#if !defined(FGPIO_H_)
#define FGPIO_H_                                 /**< Symbol preventing repeated inclusion */

#if (defined(CPU_MCXC141VFM) || defined(CPU_MCXC141VLH))
#include "MCXC141_COMMON.h"
#elif (defined(CPU_MCXC142VFM))
#include "MCXC142_COMMON.h"
#elif (defined(CPU_MCXC242VFM) || defined(CPU_MCXC242VLH))
#include "MCXC242_COMMON.h"
#else
  #error "No valid CPU defined!"
#endif

/* ----------------------------------------------------------------------------
   -- Device Peripheral Access Layer
   ---------------------------------------------------------------------------- */

/*!
 * @addtogroup Peripheral_access_layer Device Peripheral Access Layer
 * @{
 */


/*
** Start of section using anonymous unions
*/

#if defined(__ARMCC_VERSION)
  #if (__ARMCC_VERSION >= 6010050)
    #pragma clang diagnostic push
  #else
    #pragma push
    #pragma anon_unions
  #endif
#elif defined(__CWCC__)
  #pragma push
  #pragma cpp_extensions on
#elif defined(__GNUC__)
  /* anonymous unions are enabled by default */
#elif defined(__IAR_SYSTEMS_ICC__)
  #pragma language=extended
#else
  #error Not supported compiler type
#endif

/* ----------------------------------------------------------------------------
   -- FGPIO Peripheral Access Layer
   ---------------------------------------------------------------------------- */

/*!
 * @addtogroup FGPIO_Peripheral_Access_Layer FGPIO Peripheral Access Layer
 * @{
 */

/** FGPIO - Register Layout Typedef */
typedef struct {
  __IO uint32_t PDOR;                              /**< Port Data Output Register, offset: 0x0 */
  __O  uint32_t PSOR;                              /**< Port Set Output Register, offset: 0x4 */
  __O  uint32_t PCOR;                              /**< Port Clear Output Register, offset: 0x8 */
  __O  uint32_t PTOR;                              /**< Port Toggle Output Register, offset: 0xC */
  __I  uint32_t PDIR;                              /**< Port Data Input Register, offset: 0x10 */
  __IO uint32_t PDDR;                              /**< Port Data Direction Register, offset: 0x14 */
} FGPIO_Type;

/* ----------------------------------------------------------------------------
   -- FGPIO Register Masks
   ---------------------------------------------------------------------------- */

/*!
 * @addtogroup FGPIO_Register_Masks FGPIO Register Masks
 * @{
 */

/*! @name PDOR - Port Data Output Register */
/*! @{ */

#define FGPIO_PDOR_PDO_MASK                      (0xFFFFFFFFU)
#define FGPIO_PDOR_PDO_SHIFT                     (0U)
/*! PDO - Port Data Output
 *  0b00000000000000000000000000000000..Logic level 0 is driven on pin, provided pin is configured for general-purpose output.
 *  0b00000000000000000000000000000001..Logic level 1 is driven on pin, provided pin is configured for general-purpose output.
 */
#define FGPIO_PDOR_PDO(x)                        (((uint32_t)(((uint32_t)(x)) << FGPIO_PDOR_PDO_SHIFT)) & FGPIO_PDOR_PDO_MASK)
/*! @} */

/*! @name PSOR - Port Set Output Register */
/*! @{ */

#define FGPIO_PSOR_PTSO_MASK                     (0xFFFFFFFFU)
#define FGPIO_PSOR_PTSO_SHIFT                    (0U)
/*! PTSO - Port Set Output
 *  0b00000000000000000000000000000000..Corresponding bit in PDORn does not change.
 *  0b00000000000000000000000000000001..Corresponding bit in PDORn is set to logic 1.
 */
#define FGPIO_PSOR_PTSO(x)                       (((uint32_t)(((uint32_t)(x)) << FGPIO_PSOR_PTSO_SHIFT)) & FGPIO_PSOR_PTSO_MASK)
/*! @} */

/*! @name PCOR - Port Clear Output Register */
/*! @{ */

#define FGPIO_PCOR_PTCO_MASK                     (0xFFFFFFFFU)
#define FGPIO_PCOR_PTCO_SHIFT                    (0U)
/*! PTCO - Port Clear Output
 *  0b00000000000000000000000000000000..Corresponding bit in PDORn does not change.
 *  0b00000000000000000000000000000001..Corresponding bit in PDORn is cleared to logic 0.
 */
#define FGPIO_PCOR_PTCO(x)                       (((uint32_t)(((uint32_t)(x)) << FGPIO_PCOR_PTCO_SHIFT)) & FGPIO_PCOR_PTCO_MASK)
/*! @} */

/*! @name PTOR - Port Toggle Output Register */
/*! @{ */

#define FGPIO_PTOR_PTTO_MASK                     (0xFFFFFFFFU)
#define FGPIO_PTOR_PTTO_SHIFT                    (0U)
/*! PTTO - Port Toggle Output
 *  0b00000000000000000000000000000000..Corresponding bit in PDORn does not change.
 *  0b00000000000000000000000000000001..Corresponding bit in PDORn is set to the inverse of its existing logic state.
 */
#define FGPIO_PTOR_PTTO(x)                       (((uint32_t)(((uint32_t)(x)) << FGPIO_PTOR_PTTO_SHIFT)) & FGPIO_PTOR_PTTO_MASK)
/*! @} */

/*! @name PDIR - Port Data Input Register */
/*! @{ */

#define FGPIO_PDIR_PDI_MASK                      (0xFFFFFFFFU)
#define FGPIO_PDIR_PDI_SHIFT                     (0U)
/*! PDI - Port Data Input
 *  0b00000000000000000000000000000000..Pin logic level is logic 0, or is not configured for use by digital function.
 *  0b00000000000000000000000000000001..Pin logic level is logic 1.
 */
#define FGPIO_PDIR_PDI(x)                        (((uint32_t)(((uint32_t)(x)) << FGPIO_PDIR_PDI_SHIFT)) & FGPIO_PDIR_PDI_MASK)
/*! @} */

/*! @name PDDR - Port Data Direction Register */
/*! @{ */

#define FGPIO_PDDR_PDD_MASK                      (0xFFFFFFFFU)
#define FGPIO_PDDR_PDD_SHIFT                     (0U)
/*! PDD - Port Data Direction
 *  0b00000000000000000000000000000000..Pin is configured as general-purpose input, for the GPIO function.
 *  0b00000000000000000000000000000001..Pin is configured as general-purpose output, for the GPIO function.
 */
#define FGPIO_PDDR_PDD(x)                        (((uint32_t)(((uint32_t)(x)) << FGPIO_PDDR_PDD_SHIFT)) & FGPIO_PDDR_PDD_MASK)
/*! @} */


/*!
 * @}
 */ /* end of group FGPIO_Register_Masks */


/*!
 * @}
 */ /* end of group FGPIO_Peripheral_Access_Layer */


/*
** End of section using anonymous unions
*/

#if defined(__ARMCC_VERSION)
  #if (__ARMCC_VERSION >= 6010050)
    #pragma clang diagnostic pop
  #else
    #pragma pop
  #endif
#elif defined(__CWCC__)
  #pragma pop
#elif defined(__GNUC__)
  /* leave anonymous unions enabled */
#elif defined(__IAR_SYSTEMS_ICC__)
  #pragma language=default
#else
  #error Not supported compiler type
#endif

/*!
 * @}
 */ /* end of group Peripheral_access_layer */


#endif  /* FGPIO_H_ */
