vojt444/picoballoon/SW/picoballoon_v1/MCXC242_Project/device/MCXC242_COMMON.h

/*
** ###################################################################
**     Processors:          MCXC242VFM
**                          MCXC242VLH
**
**     Compilers:           Freescale C/C++ for Embedded ARM
**                          GNU C Compiler
**                          IAR ANSI C/C++ Compiler for ARM
**                          Keil ARM C/C++ Compiler
**                          MCUXpresso Compiler
**
**     Reference manual:    MCXC242RM, Rev.1, Mar 2024
**     Version:             rev. 1.6, 2016-06-24
**     Build:               b240705
**
**     Abstract:
**         CMSIS Peripheral Access Layer for MCXC242
**
**     Copyright 1997-2016 Freescale Semiconductor, Inc.
**     Copyright 2016-2024 NXP
**     SPDX-License-Identifier: BSD-3-Clause
**
**     http:                 www.nxp.com
**     mail:                 support@nxp.com
**
**     Revisions:
**     - rev. 1.0 (2014-05-12)
**         Initial version.
**     - rev. 1.1 (2014-07-10)
**         UART0 - UART0 module renamed to UART2.
**     - rev. 1.2 (2014-08-12)
**         CRC - CRC register renamed to DATA.
**     - rev. 1.3 (2014-09-02)
**         USB - USB0_CTL0 was renamed to USB0_OTGCTL register.
**         USB - USB0_CTL1 was renamed to USB0_CTL register.
**         USB - Two new bitfields (STOP_ACK_DLY_EN, AHB_DLY_EN) was added to the USB0_KEEP_ALIVE_CTRL register.
**     - rev. 1.4 (2014-09-22)
**         FLEXIO - Offsets of the SHIFTBUFBIS registers were interchanged with offsets of the SHIFTBUFBBS registers.
**         SIM - Changed bitfield value MCGIRCLK to LIRC_CLK of bitfield CLKOUTSEL in SOPT2 register.
**         SIM - Removed bitfield DIEID in SDID register.
**         UART2 - Removed ED register.
**         UART2 - Removed MODEM register.
**         UART2 - Removed IR register.
**         UART2 - Removed PFIFO register.
**         UART2 - Removed CFIFO register.
**         UART2 - Removed SFIFO register.
**         UART2 - Removed TWFIFO register.
**         UART2 - Removed TCFIFO register.
**         UART2 - Removed RWFIFO register.
**         UART2 - Removed RCFIFO register.
**         USB - Removed bitfield REG_EN in CLK_RECOVER_IRC_EN register.
**         USB - Renamed USBEN bitfield of USB0_CTL was renamed to USBENSOFEN.
**     - rev. 1.5 (2016-02-02)
**         FGPIO - Add FGPIO registers.
**     - rev. 1.6 (2016-06-24)
**         USB - OTGCTL register was removed.
**         USB - Bit RESUME was added in CTL register.
**
** ###################################################################
*/

/*!
 * @file MCXC242_COMMON.h
 * @version 1.6
 * @date 2016-06-24
 * @brief CMSIS Peripheral Access Layer for MCXC242
 *
 * CMSIS Peripheral Access Layer for MCXC242
 */

#if !defined(MCXC242_COMMON_H_)
#define MCXC242_COMMON_H_                        /**< Symbol preventing repeated inclusion */

/** Memory map major version (memory maps with equal major version number are
 * compatible) */
#define MCU_MEM_MAP_VERSION 0x0100U
/** Memory map minor version */
#define MCU_MEM_MAP_VERSION_MINOR 0x0006U


/* ----------------------------------------------------------------------------
   -- Interrupt vector numbers
   ---------------------------------------------------------------------------- */

/*!
 * @addtogroup Interrupt_vector_numbers Interrupt vector numbers
 * @{
 */

/** Interrupt Number Definitions */
#define NUMBER_OF_INT_VECTORS 48                 /**< Number of interrupts in the Vector table */

typedef enum IRQn {
  /* Auxiliary constants */
  NotAvail_IRQn                = -128,             /**< Not available device specific interrupt */

  /* Core interrupts */
  NonMaskableInt_IRQn          = -14,              /**< Non Maskable Interrupt */
  HardFault_IRQn               = -13,              /**< Cortex-M0 SV Hard Fault Interrupt */
  SVCall_IRQn                  = -5,               /**< Cortex-M0 SV Call Interrupt */
  PendSV_IRQn                  = -2,               /**< Cortex-M0 Pend SV Interrupt */
  SysTick_IRQn                 = -1,               /**< Cortex-M0 System Tick Interrupt */

  /* Device specific interrupts */
  DMA0_IRQn                    = 0,                /**< DMA channel 0 transfer complete */
  DMA1_IRQn                    = 1,                /**< DMA channel 1 transfer complete */
  DMA2_IRQn                    = 2,                /**< DMA channel 2 transfer complete */
  DMA3_IRQn                    = 3,                /**< DMA channel 3 transfer complete */
  Reserved20_IRQn              = 4,                /**< Reserved interrupt */
  FTFA_IRQn                    = 5,                /**< Command complete and read collision */
  PMC_IRQn                     = 6,                /**< Low-voltage detect, low-voltage warning */
  LLWU_IRQn                    = 7,                /**< Low leakage wakeup */
  I2C0_IRQn                    = 8,                /**< I2C0 interrupt */
  I2C1_IRQn                    = 9,                /**< I2C1 interrupt */
  SPI0_IRQn                    = 10,               /**< SPI0 single interrupt vector for all sources */
  SPI1_IRQn                    = 11,               /**< SPI1 single interrupt vector for all sources */
  LPUART0_IRQn                 = 12,               /**< LPUART0 status and error */
  LPUART1_IRQn                 = 13,               /**< LPUART1 status and error */
  UART2_FLEXIO_IRQn            = 14,               /**< UART2 or FLEXIO */
  ADC0_IRQn                    = 15,               /**< ADC0 interrupt */
  CMP0_IRQn                    = 16,               /**< CMP0 interrupt */
  TPM0_IRQn                    = 17,               /**< TPM0 single interrupt vector for all sources */
  TPM1_IRQn                    = 18,               /**< TPM1 single interrupt vector for all sources */
  TPM2_IRQn                    = 19,               /**< TPM2 single interrupt vector for all sources */
  RTC_IRQn                     = 20,               /**< RTC alarm */
  RTC_Seconds_IRQn             = 21,               /**< RTC seconds */
  PIT_IRQn                     = 22,               /**< PIT interrupt */
  Reserved39_IRQn              = 23,               /**< Reserved interrupt */
  USB0_IRQn                    = 24,               /**< USB0 interrupt */
  Reserved41_IRQn              = 25,               /**< Reserved interrupt */
  Reserved42_IRQn              = 26,               /**< Reserved interrupt */
  Reserved43_IRQn              = 27,               /**< Reserved interrupt */
  LPTMR0_IRQn                  = 28,               /**< LPTMR0 interrupt */
  Reserved45_IRQn              = 29,               /**< Reserved interrupt */
  PORTA_IRQn                   = 30,               /**< PORTA Pin detect */
  PORTB_PORTC_PORTD_PORTE_IRQn = 31                /**< Single interrupt vector for PORTB,PORTC,PORTD,PORTE */
} IRQn_Type;

/*!
 * @}
 */ /* end of group Interrupt_vector_numbers */


/* ----------------------------------------------------------------------------
   -- Cortex M0 Core Configuration
   ---------------------------------------------------------------------------- */

/*!
 * @addtogroup Cortex_Core_Configuration Cortex M0 Core Configuration
 * @{
 */

#define __CM0PLUS_REV                  0x0000    /**< Core revision r0p0 */
#define __MPU_PRESENT                  0         /**< Defines if an MPU is present or not */
#define __VTOR_PRESENT                 1         /**< Defines if VTOR is present or not */
#define __NVIC_PRIO_BITS               2         /**< Number of priority bits implemented in the NVIC */
#define __Vendor_SysTickConfig         0         /**< Vendor specific implementation of SysTickConfig is defined */

#include "core_cm0plus.h"              /* Core Peripheral Access Layer */
#include "system_MCXC242.h"            /* Device specific configuration file */

#define MCXC242_SERIES
/* CPU specific feature definitions */
#include "MCXC242_features.h"

/*!
 * @}
 */ /* end of group Cortex_Core_Configuration */


/* ADC - Peripheral instance base addresses */
/** Peripheral ADC0 base address */
#define ADC0_BASE                                (0x4003B000u)
/** Peripheral ADC0 base pointer */
#define ADC0                                     ((ADC_Type *)ADC0_BASE)
/** Array initializer of ADC peripheral base addresses */
#define ADC_BASE_ADDRS                           { ADC0_BASE }
/** Array initializer of ADC peripheral base pointers */
#define ADC_BASE_PTRS                            { ADC0 }
/** Interrupt vectors for the ADC peripheral type */
#define ADC_IRQS                                 { ADC0_IRQn }

/* CMP - Peripheral instance base addresses */
/** Peripheral CMP0 base address */
#define CMP0_BASE                                (0x40073000u)
/** Peripheral CMP0 base pointer */
#define CMP0                                     ((CMP_Type *)CMP0_BASE)
/** Array initializer of CMP peripheral base addresses */
#define CMP_BASE_ADDRS                           { CMP0_BASE }
/** Array initializer of CMP peripheral base pointers */
#define CMP_BASE_PTRS                            { CMP0 }
/** Interrupt vectors for the CMP peripheral type */
#define CMP_IRQS                                 { CMP0_IRQn }

/* CRC - Peripheral instance base addresses */
/** Peripheral CRC base address */
#define CRC_BASE                                 (0x40032000u)
/** Peripheral CRC base pointer */
#define CRC                                      ((CRC_Type *)CRC_BASE)
/** Array initializer of CRC peripheral base addresses */
#define CRC_BASE_ADDRS                           { CRC_BASE }
/** Array initializer of CRC peripheral base pointers */
#define CRC_BASE_PTRS                            { CRC }

/* DMA - Peripheral instance base addresses */
/** Peripheral DMA base address */
#define DMA_BASE                                 (0x40008000u)
/** Peripheral DMA base pointer */
#define DMA0                                     ((DMA_Type *)DMA_BASE)
/** Array initializer of DMA peripheral base addresses */
#define DMA_BASE_ADDRS                           { DMA_BASE }
/** Array initializer of DMA peripheral base pointers */
#define DMA_BASE_PTRS                            { DMA0 }
/** Interrupt vectors for the DMA peripheral type */
#define DMA_CHN_IRQS                             { { DMA0_IRQn, DMA1_IRQn, DMA2_IRQn, DMA3_IRQn } }

/* DMAMUX - Peripheral instance base addresses */
/** Peripheral DMAMUX0 base address */
#define DMAMUX0_BASE                             (0x40021000u)
/** Peripheral DMAMUX0 base pointer */
#define DMAMUX0                                  ((DMAMUX_Type *)DMAMUX0_BASE)
/** Array initializer of DMAMUX peripheral base addresses */
#define DMAMUX_BASE_ADDRS                        { DMAMUX0_BASE }
/** Array initializer of DMAMUX peripheral base pointers */
#define DMAMUX_BASE_PTRS                         { DMAMUX0 }

/* FGPIO - Peripheral instance base addresses */
/** Peripheral FGPIOA base address */
#define FGPIOA_BASE                              (0xF8000000u)
/** Peripheral FGPIOA base pointer */
#define FGPIOA                                   ((FGPIO_Type *)FGPIOA_BASE)
/** Peripheral FGPIOB base address */
#define FGPIOB_BASE                              (0xF8000040u)
/** Peripheral FGPIOB base pointer */
#define FGPIOB                                   ((FGPIO_Type *)FGPIOB_BASE)
/** Peripheral FGPIOC base address */
#define FGPIOC_BASE                              (0xF8000080u)
/** Peripheral FGPIOC base pointer */
#define FGPIOC                                   ((FGPIO_Type *)FGPIOC_BASE)
/** Peripheral FGPIOD base address */
#define FGPIOD_BASE                              (0xF80000C0u)
/** Peripheral FGPIOD base pointer */
#define FGPIOD                                   ((FGPIO_Type *)FGPIOD_BASE)
/** Peripheral FGPIOE base address */
#define FGPIOE_BASE                              (0xF8000100u)
/** Peripheral FGPIOE base pointer */
#define FGPIOE                                   ((FGPIO_Type *)FGPIOE_BASE)
/** Array initializer of FGPIO peripheral base addresses */
#define FGPIO_BASE_ADDRS                         { FGPIOA_BASE, FGPIOB_BASE, FGPIOC_BASE, FGPIOD_BASE, FGPIOE_BASE }
/** Array initializer of FGPIO peripheral base pointers */
#define FGPIO_BASE_PTRS                          { FGPIOA, FGPIOB, FGPIOC, FGPIOD, FGPIOE }

/* FLEXIO - Peripheral instance base addresses */
/** Peripheral FLEXIO base address */
#define FLEXIO_BASE                              (0x4005F000u)
/** Peripheral FLEXIO base pointer */
#define FLEXIO                                   ((FLEXIO_Type *)FLEXIO_BASE)
/** Array initializer of FLEXIO peripheral base addresses */
#define FLEXIO_BASE_ADDRS                        { FLEXIO_BASE }
/** Array initializer of FLEXIO peripheral base pointers */
#define FLEXIO_BASE_PTRS                         { FLEXIO }
/** Interrupt vectors for the FLEXIO peripheral type */
#define FLEXIO_IRQS                              { UART2_FLEXIO_IRQn }

/* FTFA - Peripheral instance base addresses */
/** Peripheral FTFA base address */
#define FTFA_BASE                                (0x40020000u)
/** Peripheral FTFA base pointer */
#define FTFA                                     ((FTFA_Type *)FTFA_BASE)
/** Array initializer of FTFA peripheral base addresses */
#define FTFA_BASE_ADDRS                          { FTFA_BASE }
/** Array initializer of FTFA peripheral base pointers */
#define FTFA_BASE_PTRS                           { FTFA }
/** Interrupt vectors for the FTFA peripheral type */
#define FTFA_COMMAND_COMPLETE_IRQS               { FTFA_IRQn }

/* GPIO - Peripheral instance base addresses */
/** Peripheral GPIOA base address */
#define GPIOA_BASE                               (0x400FF000u)
/** Peripheral GPIOA base pointer */
#define GPIOA                                    ((GPIO_Type *)GPIOA_BASE)
/** Peripheral GPIOB base address */
#define GPIOB_BASE                               (0x400FF040u)
/** Peripheral GPIOB base pointer */
#define GPIOB                                    ((GPIO_Type *)GPIOB_BASE)
/** Peripheral GPIOC base address */
#define GPIOC_BASE                               (0x400FF080u)
/** Peripheral GPIOC base pointer */
#define GPIOC                                    ((GPIO_Type *)GPIOC_BASE)
/** Peripheral GPIOD base address */
#define GPIOD_BASE                               (0x400FF0C0u)
/** Peripheral GPIOD base pointer */
#define GPIOD                                    ((GPIO_Type *)GPIOD_BASE)
/** Peripheral GPIOE base address */
#define GPIOE_BASE                               (0x400FF100u)
/** Peripheral GPIOE base pointer */
#define GPIOE                                    ((GPIO_Type *)GPIOE_BASE)
/** Array initializer of GPIO peripheral base addresses */
#define GPIO_BASE_ADDRS                          { GPIOA_BASE, GPIOB_BASE, GPIOC_BASE, GPIOD_BASE, GPIOE_BASE }
/** Array initializer of GPIO peripheral base pointers */
#define GPIO_BASE_PTRS                           { GPIOA, GPIOB, GPIOC, GPIOD, GPIOE }

/* I2C - Peripheral instance base addresses */
/** Peripheral I2C0 base address */
#define I2C0_BASE                                (0x40066000u)
/** Peripheral I2C0 base pointer */
#define I2C0                                     ((I2C_Type *)I2C0_BASE)
/** Peripheral I2C1 base address */
#define I2C1_BASE                                (0x40067000u)
/** Peripheral I2C1 base pointer */
#define I2C1                                     ((I2C_Type *)I2C1_BASE)
/** Array initializer of I2C peripheral base addresses */
#define I2C_BASE_ADDRS                           { I2C0_BASE, I2C1_BASE }
/** Array initializer of I2C peripheral base pointers */
#define I2C_BASE_PTRS                            { I2C0, I2C1 }
/** Interrupt vectors for the I2C peripheral type */
#define I2C_IRQS                                 { I2C0_IRQn, I2C1_IRQn }

/* LLWU - Peripheral instance base addresses */
/** Peripheral LLWU base address */
#define LLWU_BASE                                (0x4007C000u)
/** Peripheral LLWU base pointer */
#define LLWU                                     ((LLWU_Type *)LLWU_BASE)
/** Array initializer of LLWU peripheral base addresses */
#define LLWU_BASE_ADDRS                          { LLWU_BASE }
/** Array initializer of LLWU peripheral base pointers */
#define LLWU_BASE_PTRS                           { LLWU }
/** Interrupt vectors for the LLWU peripheral type */
#define LLWU_IRQS                                { LLWU_IRQn }

/* LPTMR - Peripheral instance base addresses */
/** Peripheral LPTMR0 base address */
#define LPTMR0_BASE                              (0x40040000u)
/** Peripheral LPTMR0 base pointer */
#define LPTMR0                                   ((LPTMR_Type *)LPTMR0_BASE)
/** Array initializer of LPTMR peripheral base addresses */
#define LPTMR_BASE_ADDRS                         { LPTMR0_BASE }
/** Array initializer of LPTMR peripheral base pointers */
#define LPTMR_BASE_PTRS                          { LPTMR0 }
/** Interrupt vectors for the LPTMR peripheral type */
#define LPTMR_IRQS                               { LPTMR0_IRQn }

/* LPUART - Peripheral instance base addresses */
/** Peripheral LPUART0 base address */
#define LPUART0_BASE                             (0x40054000u)
/** Peripheral LPUART0 base pointer */
#define LPUART0                                  ((LPUART_Type *)LPUART0_BASE)
/** Peripheral LPUART1 base address */
#define LPUART1_BASE                             (0x40055000u)
/** Peripheral LPUART1 base pointer */
#define LPUART1                                  ((LPUART_Type *)LPUART1_BASE)
/** Array initializer of LPUART peripheral base addresses */
#define LPUART_BASE_ADDRS                        { LPUART0_BASE, LPUART1_BASE }
/** Array initializer of LPUART peripheral base pointers */
#define LPUART_BASE_PTRS                         { LPUART0, LPUART1 }
/** Interrupt vectors for the LPUART peripheral type */
#define LPUART_RX_TX_IRQS                        { LPUART0_IRQn, LPUART1_IRQn }
#define LPUART_ERR_IRQS                          { LPUART0_IRQn, LPUART1_IRQn }

/* MCG - Peripheral instance base addresses */
/** Peripheral MCG base address */
#define MCG_BASE                                 (0x40064000u)
/** Peripheral MCG base pointer */
#define MCG                                      ((MCG_Type *)MCG_BASE)
/** Array initializer of MCG peripheral base addresses */
#define MCG_BASE_ADDRS                           { MCG_BASE }
/** Array initializer of MCG peripheral base pointers */
#define MCG_BASE_PTRS                            { MCG }

/* MCM - Peripheral instance base addresses */
/** Peripheral MCM base address */
#define MCM_BASE                                 (0xF0003000u)
/** Peripheral MCM base pointer */
#define MCM                                      ((MCM_Type *)MCM_BASE)
/** Array initializer of MCM peripheral base addresses */
#define MCM_BASE_ADDRS                           { MCM_BASE }
/** Array initializer of MCM peripheral base pointers */
#define MCM_BASE_PTRS                            { MCM }

/* MTB - Peripheral instance base addresses */
/** Peripheral MTB base address */
#define MTB_BASE                                 (0xF0000000u)
/** Peripheral MTB base pointer */
#define MTB                                      ((MTB_Type *)MTB_BASE)
/** Array initializer of MTB peripheral base addresses */
#define MTB_BASE_ADDRS                           { MTB_BASE }
/** Array initializer of MTB peripheral base pointers */
#define MTB_BASE_PTRS                            { MTB }

/* MTBDWT - Peripheral instance base addresses */
/** Peripheral MTBDWT base address */
#define MTBDWT_BASE                              (0xF0001000u)
/** Peripheral MTBDWT base pointer */
#define MTBDWT                                   ((MTBDWT_Type *)MTBDWT_BASE)
/** Array initializer of MTBDWT peripheral base addresses */
#define MTBDWT_BASE_ADDRS                        { MTBDWT_BASE }
/** Array initializer of MTBDWT peripheral base pointers */
#define MTBDWT_BASE_PTRS                         { MTBDWT }

/* NV - Peripheral instance base addresses */
/** Peripheral FTFA_FlashConfig base address */
#define FTFA_FlashConfig_BASE                    (0x400u)
/** Peripheral FTFA_FlashConfig base pointer */
#define FTFA_FlashConfig                         ((NV_Type *)FTFA_FlashConfig_BASE)
/** Array initializer of NV peripheral base addresses */
#define NV_BASE_ADDRS                            { FTFA_FlashConfig_BASE }
/** Array initializer of NV peripheral base pointers */
#define NV_BASE_PTRS                             { FTFA_FlashConfig }

/* OSC - Peripheral instance base addresses */
/** Peripheral OSC0 base address */
#define OSC0_BASE                                (0x40065000u)
/** Peripheral OSC0 base pointer */
#define OSC0                                     ((OSC_Type *)OSC0_BASE)
/** Array initializer of OSC peripheral base addresses */
#define OSC_BASE_ADDRS                           { OSC0_BASE }
/** Array initializer of OSC peripheral base pointers */
#define OSC_BASE_PTRS                            { OSC0 }

/* PIT - Peripheral instance base addresses */
/** Peripheral PIT base address */
#define PIT_BASE                                 (0x40037000u)
/** Peripheral PIT base pointer */
#define PIT                                      ((PIT_Type *)PIT_BASE)
/** Array initializer of PIT peripheral base addresses */
#define PIT_BASE_ADDRS                           { PIT_BASE }
/** Array initializer of PIT peripheral base pointers */
#define PIT_BASE_PTRS                            { PIT }
/** Interrupt vectors for the PIT peripheral type */
#define PIT_IRQS                                 { { PIT_IRQn, PIT_IRQn } }

/* PMC - Peripheral instance base addresses */
/** Peripheral PMC base address */
#define PMC_BASE                                 (0x4007D000u)
/** Peripheral PMC base pointer */
#define PMC                                      ((PMC_Type *)PMC_BASE)
/** Array initializer of PMC peripheral base addresses */
#define PMC_BASE_ADDRS                           { PMC_BASE }
/** Array initializer of PMC peripheral base pointers */
#define PMC_BASE_PTRS                            { PMC }
/** Interrupt vectors for the PMC peripheral type */
#define PMC_IRQS                                 { PMC_IRQn }

/* PORT - Peripheral instance base addresses */
/** Peripheral PORTA base address */
#define PORTA_BASE                               (0x40049000u)
/** Peripheral PORTA base pointer */
#define PORTA                                    ((PORT_Type *)PORTA_BASE)
/** Peripheral PORTB base address */
#define PORTB_BASE                               (0x4004A000u)
/** Peripheral PORTB base pointer */
#define PORTB                                    ((PORT_Type *)PORTB_BASE)
/** Peripheral PORTC base address */
#define PORTC_BASE                               (0x4004B000u)
/** Peripheral PORTC base pointer */
#define PORTC                                    ((PORT_Type *)PORTC_BASE)
/** Peripheral PORTD base address */
#define PORTD_BASE                               (0x4004C000u)
/** Peripheral PORTD base pointer */
#define PORTD                                    ((PORT_Type *)PORTD_BASE)
/** Peripheral PORTE base address */
#define PORTE_BASE                               (0x4004D000u)
/** Peripheral PORTE base pointer */
#define PORTE                                    ((PORT_Type *)PORTE_BASE)
/** Array initializer of PORT peripheral base addresses */
#define PORT_BASE_ADDRS                          { PORTA_BASE, PORTB_BASE, PORTC_BASE, PORTD_BASE, PORTE_BASE }
/** Array initializer of PORT peripheral base pointers */
#define PORT_BASE_PTRS                           { PORTA, PORTB, PORTC, PORTD, PORTE }
/** Interrupt vectors for the PORT peripheral type */
#define PORT_IRQS                                { PORTA_IRQn, PORTB_PORTC_PORTD_PORTE_IRQn, PORTB_PORTC_PORTD_PORTE_IRQn, PORTB_PORTC_PORTD_PORTE_IRQn, PORTB_PORTC_PORTD_PORTE_IRQn }

/* RCM - Peripheral instance base addresses */
/** Peripheral RCM base address */
#define RCM_BASE                                 (0x4007F000u)
/** Peripheral RCM base pointer */
#define RCM                                      ((RCM_Type *)RCM_BASE)
/** Array initializer of RCM peripheral base addresses */
#define RCM_BASE_ADDRS                           { RCM_BASE }
/** Array initializer of RCM peripheral base pointers */
#define RCM_BASE_PTRS                            { RCM }

/* RFSYS - Peripheral instance base addresses */
/** Peripheral RFSYS base address */
#define RFSYS_BASE                               (0x40041000u)
/** Peripheral RFSYS base pointer */
#define RFSYS                                    ((RFSYS_Type *)RFSYS_BASE)
/** Array initializer of RFSYS peripheral base addresses */
#define RFSYS_BASE_ADDRS                         { RFSYS_BASE }
/** Array initializer of RFSYS peripheral base pointers */
#define RFSYS_BASE_PTRS                          { RFSYS }

/* ROM - Peripheral instance base addresses */
/** Peripheral ROM base address */
#define ROM_BASE                                 (0xF0002000u)
/** Peripheral ROM base pointer */
#define ROM                                      ((ROM_Type *)ROM_BASE)
/** Array initializer of ROM peripheral base addresses */
#define ROM_BASE_ADDRS                           { ROM_BASE }
/** Array initializer of ROM peripheral base pointers */
#define ROM_BASE_PTRS                            { ROM }

/* RTC - Peripheral instance base addresses */
/** Peripheral RTC base address */
#define RTC_BASE                                 (0x4003D000u)
/** Peripheral RTC base pointer */
#define RTC                                      ((RTC_Type *)RTC_BASE)
/** Array initializer of RTC peripheral base addresses */
#define RTC_BASE_ADDRS                           { RTC_BASE }
/** Array initializer of RTC peripheral base pointers */
#define RTC_BASE_PTRS                            { RTC }
/** Interrupt vectors for the RTC peripheral type */
#define RTC_IRQS                                 { RTC_IRQn }
#define RTC_SECONDS_IRQS                         { RTC_Seconds_IRQn }

/* SIM - Peripheral instance base addresses */
/** Peripheral SIM base address */
#define SIM_BASE                                 (0x40047000u)
/** Peripheral SIM base pointer */
#define SIM                                      ((SIM_Type *)SIM_BASE)
/** Array initializer of SIM peripheral base addresses */
#define SIM_BASE_ADDRS                           { SIM_BASE }
/** Array initializer of SIM peripheral base pointers */
#define SIM_BASE_PTRS                            { SIM }

/* SMC - Peripheral instance base addresses */
/** Peripheral SMC base address */
#define SMC_BASE                                 (0x4007E000u)
/** Peripheral SMC base pointer */
#define SMC                                      ((SMC_Type *)SMC_BASE)
/** Array initializer of SMC peripheral base addresses */
#define SMC_BASE_ADDRS                           { SMC_BASE }
/** Array initializer of SMC peripheral base pointers */
#define SMC_BASE_PTRS                            { SMC }

/* SPI - Peripheral instance base addresses */
/** Peripheral SPI0 base address */
#define SPI0_BASE                                (0x40076000u)
/** Peripheral SPI0 base pointer */
#define SPI0                                     ((SPI_Type *)SPI0_BASE)
/** Peripheral SPI1 base address */
#define SPI1_BASE                                (0x40077000u)
/** Peripheral SPI1 base pointer */
#define SPI1                                     ((SPI_Type *)SPI1_BASE)
/** Array initializer of SPI peripheral base addresses */
#define SPI_BASE_ADDRS                           { SPI0_BASE, SPI1_BASE }
/** Array initializer of SPI peripheral base pointers */
#define SPI_BASE_PTRS                            { SPI0, SPI1 }
/** Interrupt vectors for the SPI peripheral type */
#define SPI_IRQS                                 { SPI0_IRQn, SPI1_IRQn }

/* TPM - Peripheral instance base addresses */
/** Peripheral TPM0 base address */
#define TPM0_BASE                                (0x40038000u)
/** Peripheral TPM0 base pointer */
#define TPM0                                     ((TPM_Type *)TPM0_BASE)
/** Peripheral TPM1 base address */
#define TPM1_BASE                                (0x40039000u)
/** Peripheral TPM1 base pointer */
#define TPM1                                     ((TPM_Type *)TPM1_BASE)
/** Peripheral TPM2 base address */
#define TPM2_BASE                                (0x4003A000u)
/** Peripheral TPM2 base pointer */
#define TPM2                                     ((TPM_Type *)TPM2_BASE)
/** Array initializer of TPM peripheral base addresses */
#define TPM_BASE_ADDRS                           { TPM0_BASE, TPM1_BASE, TPM2_BASE }
/** Array initializer of TPM peripheral base pointers */
#define TPM_BASE_PTRS                            { TPM0, TPM1, TPM2 }
/** Interrupt vectors for the TPM peripheral type */
#define TPM_IRQS                                 { TPM0_IRQn, TPM1_IRQn, TPM2_IRQn }

/* UART - Peripheral instance base addresses */
/** Peripheral UART2 base address */
#define UART2_BASE                               (0x4006C000u)
/** Peripheral UART2 base pointer */
#define UART2                                    ((UART_Type *)UART2_BASE)
/** Array initializer of UART peripheral base addresses */
#define UART_BASE_ADDRS                          { 0u, 0u, UART2_BASE }
/** Array initializer of UART peripheral base pointers */
#define UART_BASE_PTRS                           { (UART_Type *)0u, (UART_Type *)0u, UART2 }
/** Interrupt vectors for the UART peripheral type */
#define UART_RX_TX_IRQS                          { NotAvail_IRQn, NotAvail_IRQn, UART2_FLEXIO_IRQn }
#define UART_ERR_IRQS                            { NotAvail_IRQn, NotAvail_IRQn, UART2_FLEXIO_IRQn }

/* USB - Peripheral instance base addresses */
/** Peripheral USB0 base address */
#define USB0_BASE                                (0x40072000u)
/** Peripheral USB0 base pointer */
#define USB0                                     ((USB_Type *)USB0_BASE)
/** Array initializer of USB peripheral base addresses */
#define USB_BASE_ADDRS                           { USB0_BASE }
/** Array initializer of USB peripheral base pointers */
#define USB_BASE_PTRS                            { USB0 }
/** Interrupt vectors for the USB peripheral type */
#define USB_IRQS                                 { USB0_IRQn }

/* VREF - Peripheral instance base addresses */
/** Peripheral VREF base address */
#define VREF_BASE                                (0x40074000u)
/** Peripheral VREF base pointer */
#define VREF                                     ((VREF_Type *)VREF_BASE)
/** Array initializer of VREF peripheral base addresses */
#define VREF_BASE_ADDRS                          { VREF_BASE }
/** Array initializer of VREF peripheral base pointers */
#define VREF_BASE_PTRS                           { VREF }

/* ----------------------------------------------------------------------------
   -- Macros for use with bit field definitions (xxx_SHIFT, xxx_MASK).
   ---------------------------------------------------------------------------- */

/*!
 * @addtogroup Bit_Field_Generic_Macros Macros for use with bit field definitions (xxx_SHIFT, xxx_MASK).
 * @{
 */

#if defined(__ARMCC_VERSION)
  #if (__ARMCC_VERSION >= 6010050)
    #pragma clang system_header
  #endif
#elif defined(__IAR_SYSTEMS_ICC__)
  #pragma system_include
#endif

/**
 * @brief Mask and left-shift a bit field value for use in a register bit range.
 * @param field Name of the register bit field.
 * @param value Value of the bit field.
 * @return Masked and shifted value.
 */
#define NXP_VAL2FLD(field, value)    (((value) << (field ## _SHIFT)) & (field ## _MASK))
/**
 * @brief Mask and right-shift a register value to extract a bit field value.
 * @param field Name of the register bit field.
 * @param value Value of the register.
 * @return Masked and shifted bit field value.
 */
#define NXP_FLD2VAL(field, value)    (((value) & (field ## _MASK)) >> (field ## _SHIFT))

/*!
 * @}
 */ /* end of group Bit_Field_Generic_Macros */


/* ----------------------------------------------------------------------------
   -- SDK Compatibility
   ---------------------------------------------------------------------------- */

/*!
 * @addtogroup SDK_Compatibility_Symbols SDK Compatibility
 * @{
 */

/* No SDK compatibility issues. */

/*!
 * @}
 */ /* end of group SDK_Compatibility_Symbols */


#endif  /* MCXC242_COMMON_H_ */
