vojt444/picoballoon/SW/picoballoon_v1/MCXC242_Project/device/periph1/PERI_ADC.h

/*
** ###################################################################
**     Processors:          MCXC141VFM
**                          MCXC141VLH
**                          MCXC142VFM
**                          MCXC242VFM
**                          MCXC242VLH
**
**     Version:             rev. 1.6, 2016-06-24
**     Build:               b240705
**
**     Abstract:
**         CMSIS Peripheral Access Layer for ADC
**
**     Copyright 1997-2016 Freescale Semiconductor, Inc.
**     Copyright 2016-2024 NXP
**     SPDX-License-Identifier: BSD-3-Clause
**
**     http:                 www.nxp.com
**     mail:                 support@nxp.com
**
**     Revisions:
**     - rev. 1.0 (2014-05-12)
**         Initial version.
**     - rev. 1.1 (2014-07-10)
**         UART0 - UART0 module renamed to UART2.
**     - rev. 1.2 (2014-08-12)
**         CRC - CRC register renamed to DATA.
**     - rev. 1.3 (2014-09-02)
**         USB - USB0_CTL0 was renamed to USB0_OTGCTL register.
**         USB - USB0_CTL1 was renamed to USB0_CTL register.
**         USB - Two new bitfields (STOP_ACK_DLY_EN, AHB_DLY_EN) was added to the USB0_KEEP_ALIVE_CTRL register.
**     - rev. 1.4 (2014-09-22)
**         FLEXIO - Offsets of the SHIFTBUFBIS registers were interchanged with offsets of the SHIFTBUFBBS registers.
**         SIM - Changed bitfield value MCGIRCLK to LIRC_CLK of bitfield CLKOUTSEL in SOPT2 register.
**         SIM - Removed bitfield DIEID in SDID register.
**         UART2 - Removed ED register.
**         UART2 - Removed MODEM register.
**         UART2 - Removed IR register.
**         UART2 - Removed PFIFO register.
**         UART2 - Removed CFIFO register.
**         UART2 - Removed SFIFO register.
**         UART2 - Removed TWFIFO register.
**         UART2 - Removed TCFIFO register.
**         UART2 - Removed RWFIFO register.
**         UART2 - Removed RCFIFO register.
**         USB - Removed bitfield REG_EN in CLK_RECOVER_IRC_EN register.
**         USB - Renamed USBEN bitfield of USB0_CTL was renamed to USBENSOFEN.
**     - rev. 1.5 (2016-02-02)
**         FGPIO - Add FGPIO registers.
**     - rev. 1.6 (2016-06-24)
**         USB - OTGCTL register was removed.
**         USB - Bit RESUME was added in CTL register.
**
** ###################################################################
*/

/*!
 * @file ADC.h
 * @version 1.6
 * @date 2016-06-24
 * @brief CMSIS Peripheral Access Layer for ADC
 *
 * CMSIS Peripheral Access Layer for ADC
 */

#if !defined(ADC_H_)
#define ADC_H_                                   /**< Symbol preventing repeated inclusion */

#if (defined(CPU_MCXC141VFM) || defined(CPU_MCXC141VLH))
#include "MCXC141_COMMON.h"
#elif (defined(CPU_MCXC142VFM))
#include "MCXC142_COMMON.h"
#elif (defined(CPU_MCXC242VFM) || defined(CPU_MCXC242VLH))
#include "MCXC242_COMMON.h"
#else
  #error "No valid CPU defined!"
#endif

/* ----------------------------------------------------------------------------
   -- Device Peripheral Access Layer
   ---------------------------------------------------------------------------- */

/*!
 * @addtogroup Peripheral_access_layer Device Peripheral Access Layer
 * @{
 */


/*
** Start of section using anonymous unions
*/

#if defined(__ARMCC_VERSION)
  #if (__ARMCC_VERSION >= 6010050)
    #pragma clang diagnostic push
  #else
    #pragma push
    #pragma anon_unions
  #endif
#elif defined(__CWCC__)
  #pragma push
  #pragma cpp_extensions on
#elif defined(__GNUC__)
  /* anonymous unions are enabled by default */
#elif defined(__IAR_SYSTEMS_ICC__)
  #pragma language=extended
#else
  #error Not supported compiler type
#endif

/* ----------------------------------------------------------------------------
   -- ADC Peripheral Access Layer
   ---------------------------------------------------------------------------- */

/*!
 * @addtogroup ADC_Peripheral_Access_Layer ADC Peripheral Access Layer
 * @{
 */

/** ADC - Size of Registers Arrays */
#define ADC_SC1_COUNT                             2u
#define ADC_R_COUNT                               2u

/** ADC - Register Layout Typedef */
typedef struct {
  __IO uint32_t SC1[ADC_SC1_COUNT];                /**< ADC Status and Control Registers 1, array offset: 0x0, array step: 0x4 */
  __IO uint32_t CFG1;                              /**< ADC Configuration Register 1, offset: 0x8 */
  __IO uint32_t CFG2;                              /**< ADC Configuration Register 2, offset: 0xC */
  __I  uint32_t R[ADC_R_COUNT];                    /**< ADC Data Result Register, array offset: 0x10, array step: 0x4 */
  __IO uint32_t CV1;                               /**< Compare Value Registers, offset: 0x18 */
  __IO uint32_t CV2;                               /**< Compare Value Registers, offset: 0x1C */
  __IO uint32_t SC2;                               /**< Status and Control Register 2, offset: 0x20 */
  __IO uint32_t SC3;                               /**< Status and Control Register 3, offset: 0x24 */
  __IO uint32_t OFS;                               /**< ADC Offset Correction Register, offset: 0x28 */
  __IO uint32_t PG;                                /**< ADC Plus-Side Gain Register, offset: 0x2C */
  __IO uint32_t MG;                                /**< ADC Minus-Side Gain Register, offset: 0x30 */
  __IO uint32_t CLPD;                              /**< ADC Plus-Side General Calibration Value Register, offset: 0x34 */
  __IO uint32_t CLPS;                              /**< ADC Plus-Side General Calibration Value Register, offset: 0x38 */
  __IO uint32_t CLP4;                              /**< ADC Plus-Side General Calibration Value Register, offset: 0x3C */
  __IO uint32_t CLP3;                              /**< ADC Plus-Side General Calibration Value Register, offset: 0x40 */
  __IO uint32_t CLP2;                              /**< ADC Plus-Side General Calibration Value Register, offset: 0x44 */
  __IO uint32_t CLP1;                              /**< ADC Plus-Side General Calibration Value Register, offset: 0x48 */
  __IO uint32_t CLP0;                              /**< ADC Plus-Side General Calibration Value Register, offset: 0x4C */
       uint8_t RESERVED_0[4];
  __IO uint32_t CLMD;                              /**< ADC Minus-Side General Calibration Value Register, offset: 0x54 */
  __IO uint32_t CLMS;                              /**< ADC Minus-Side General Calibration Value Register, offset: 0x58 */
  __IO uint32_t CLM4;                              /**< ADC Minus-Side General Calibration Value Register, offset: 0x5C */
  __IO uint32_t CLM3;                              /**< ADC Minus-Side General Calibration Value Register, offset: 0x60 */
  __IO uint32_t CLM2;                              /**< ADC Minus-Side General Calibration Value Register, offset: 0x64 */
  __IO uint32_t CLM1;                              /**< ADC Minus-Side General Calibration Value Register, offset: 0x68 */
  __IO uint32_t CLM0;                              /**< ADC Minus-Side General Calibration Value Register, offset: 0x6C */
} ADC_Type;

/* ----------------------------------------------------------------------------
   -- ADC Register Masks
   ---------------------------------------------------------------------------- */

/*!
 * @addtogroup ADC_Register_Masks ADC Register Masks
 * @{
 */

/*! @name SC1 - ADC Status and Control Registers 1 */
/*! @{ */

#define ADC_SC1_ADCH_MASK                        (0x1FU)
#define ADC_SC1_ADCH_SHIFT                       (0U)
/*! ADCH - Input channel select
 *  0b00000..When DIFF=0, DADP0 is selected as input; when DIFF=1, DAD0 is selected as input.
 *  0b00001..When DIFF=0, DADP1 is selected as input; when DIFF=1, DAD1 is selected as input.
 *  0b00010..When DIFF=0, DADP2 is selected as input; when DIFF=1, DAD2 is selected as input.
 *  0b00011..When DIFF=0, DADP3 is selected as input; when DIFF=1, DAD3 is selected as input.
 *  0b00100..When DIFF=0, AD4 is selected as input; when DIFF=1, it is reserved.
 *  0b00101..When DIFF=0, AD5 is selected as input; when DIFF=1, it is reserved.
 *  0b00110..When DIFF=0, AD6 is selected as input; when DIFF=1, it is reserved.
 *  0b00111..When DIFF=0, AD7 is selected as input; when DIFF=1, it is reserved.
 *  0b01000..When DIFF=0, AD8 is selected as input; when DIFF=1, it is reserved.
 *  0b01001..When DIFF=0, AD9 is selected as input; when DIFF=1, it is reserved.
 *  0b01010..When DIFF=0, AD10 is selected as input; when DIFF=1, it is reserved.
 *  0b01011..When DIFF=0, AD11 is selected as input; when DIFF=1, it is reserved.
 *  0b01100..When DIFF=0, AD12 is selected as input; when DIFF=1, it is reserved.
 *  0b01101..When DIFF=0, AD13 is selected as input; when DIFF=1, it is reserved.
 *  0b01110..When DIFF=0, AD14 is selected as input; when DIFF=1, it is reserved.
 *  0b01111..When DIFF=0, AD15 is selected as input; when DIFF=1, it is reserved.
 *  0b10000..When DIFF=0, AD16 is selected as input; when DIFF=1, it is reserved.
 *  0b10001..When DIFF=0, AD17 is selected as input; when DIFF=1, it is reserved.
 *  0b10010..When DIFF=0, AD18 is selected as input; when DIFF=1, it is reserved.
 *  0b10011..When DIFF=0, AD19 is selected as input; when DIFF=1, it is reserved.
 *  0b10100..When DIFF=0, AD20 is selected as input; when DIFF=1, it is reserved.
 *  0b10101..When DIFF=0, AD21 is selected as input; when DIFF=1, it is reserved.
 *  0b10110..When DIFF=0, AD22 is selected as input; when DIFF=1, it is reserved.
 *  0b10111..When DIFF=0, AD23 is selected as input; when DIFF=1, it is reserved.
 *  0b11000..Reserved.
 *  0b11001..Reserved.
 *  0b11010..When DIFF=0, Temp Sensor (single-ended) is selected as input; when DIFF=1, Temp Sensor (differential) is selected as input.
 *  0b11011..When DIFF=0, Bandgap (single-ended) is selected as input; when DIFF=1, Bandgap (differential) is selected as input.
 *  0b11100..Reserved.
 *  0b11101..When DIFF=0,VREFSH is selected as input; when DIFF=1, -VREFSH (differential) is selected as input.
 *           Voltage reference selected is determined by SC2[REFSEL].
 *  0b11110..When DIFF=0,VREFSL is selected as input; when DIFF=1, it is reserved. Voltage reference selected is determined by SC2[REFSEL].
 *  0b11111..Module is disabled.
 */
#define ADC_SC1_ADCH(x)                          (((uint32_t)(((uint32_t)(x)) << ADC_SC1_ADCH_SHIFT)) & ADC_SC1_ADCH_MASK)

#define ADC_SC1_DIFF_MASK                        (0x20U)
#define ADC_SC1_DIFF_SHIFT                       (5U)
/*! DIFF - Differential Mode Enable
 *  0b0..Single-ended conversions and input channels are selected.
 *  0b1..Differential conversions and input channels are selected.
 */
#define ADC_SC1_DIFF(x)                          (((uint32_t)(((uint32_t)(x)) << ADC_SC1_DIFF_SHIFT)) & ADC_SC1_DIFF_MASK)

#define ADC_SC1_AIEN_MASK                        (0x40U)
#define ADC_SC1_AIEN_SHIFT                       (6U)
/*! AIEN - Interrupt Enable
 *  0b0..Conversion complete interrupt is disabled.
 *  0b1..Conversion complete interrupt is enabled.
 */
#define ADC_SC1_AIEN(x)                          (((uint32_t)(((uint32_t)(x)) << ADC_SC1_AIEN_SHIFT)) & ADC_SC1_AIEN_MASK)

#define ADC_SC1_COCO_MASK                        (0x80U)
#define ADC_SC1_COCO_SHIFT                       (7U)
/*! COCO - Conversion Complete Flag
 *  0b0..Conversion is not completed.
 *  0b1..Conversion is completed.
 */
#define ADC_SC1_COCO(x)                          (((uint32_t)(((uint32_t)(x)) << ADC_SC1_COCO_SHIFT)) & ADC_SC1_COCO_MASK)
/*! @} */

/*! @name CFG1 - ADC Configuration Register 1 */
/*! @{ */

#define ADC_CFG1_ADICLK_MASK                     (0x3U)
#define ADC_CFG1_ADICLK_SHIFT                    (0U)
/*! ADICLK - Input Clock Select
 *  0b00..Bus clock
 *  0b01..Bus clock divided by 2(BUSCLK/DIV2)
 *  0b10..Alternate clock (ALTCLK)
 *  0b11..Asynchronous clock (ADACK)
 */
#define ADC_CFG1_ADICLK(x)                       (((uint32_t)(((uint32_t)(x)) << ADC_CFG1_ADICLK_SHIFT)) & ADC_CFG1_ADICLK_MASK)

#define ADC_CFG1_MODE_MASK                       (0xCU)
#define ADC_CFG1_MODE_SHIFT                      (2U)
/*! MODE - Conversion mode selection
 *  0b00..When DIFF=0:It is single-ended 8-bit conversion; when DIFF=1, it is differential 9-bit conversion with 2's complement output.
 *  0b01..When DIFF=0:It is single-ended 12-bit conversion ; when DIFF=1, it is differential 13-bit conversion with 2's complement output.
 *  0b10..When DIFF=0:It is single-ended 10-bit conversion. ; when DIFF=1, it is differential 11-bit conversion with 2's complement output
 *  0b11..When DIFF=0:It is single-ended 16-bit conversion..; when DIFF=1, it is differential 16-bit conversion with 2's complement output
 */
#define ADC_CFG1_MODE(x)                         (((uint32_t)(((uint32_t)(x)) << ADC_CFG1_MODE_SHIFT)) & ADC_CFG1_MODE_MASK)

#define ADC_CFG1_ADLSMP_MASK                     (0x10U)
#define ADC_CFG1_ADLSMP_SHIFT                    (4U)
/*! ADLSMP - Sample Time Configuration
 *  0b0..Short sample time.
 *  0b1..Long sample time.
 */
#define ADC_CFG1_ADLSMP(x)                       (((uint32_t)(((uint32_t)(x)) << ADC_CFG1_ADLSMP_SHIFT)) & ADC_CFG1_ADLSMP_MASK)

#define ADC_CFG1_ADIV_MASK                       (0x60U)
#define ADC_CFG1_ADIV_SHIFT                      (5U)
/*! ADIV - Clock Divide Select
 *  0b00..The divide ratio is 1 and the clock rate is input clock.
 *  0b01..The divide ratio is 2 and the clock rate is (input clock)/2.
 *  0b10..The divide ratio is 4 and the clock rate is (input clock)/4.
 *  0b11..The divide ratio is 8 and the clock rate is (input clock)/8.
 */
#define ADC_CFG1_ADIV(x)                         (((uint32_t)(((uint32_t)(x)) << ADC_CFG1_ADIV_SHIFT)) & ADC_CFG1_ADIV_MASK)

#define ADC_CFG1_ADLPC_MASK                      (0x80U)
#define ADC_CFG1_ADLPC_SHIFT                     (7U)
/*! ADLPC - Low-Power Configuration
 *  0b0..Normal power configuration.
 *  0b1..Low-power configuration. The power is reduced at the expense of maximum clock speed.
 */
#define ADC_CFG1_ADLPC(x)                        (((uint32_t)(((uint32_t)(x)) << ADC_CFG1_ADLPC_SHIFT)) & ADC_CFG1_ADLPC_MASK)
/*! @} */

/*! @name CFG2 - ADC Configuration Register 2 */
/*! @{ */

#define ADC_CFG2_ADLSTS_MASK                     (0x3U)
#define ADC_CFG2_ADLSTS_SHIFT                    (0U)
/*! ADLSTS - Long Sample Time Select
 *  0b00..Default longest sample time; 20 extra ADCK cycles; 24 ADCK cycles total.
 *  0b01..12 extra ADCK cycles; 16 ADCK cycles total sample time.
 *  0b10..6 extra ADCK cycles; 10 ADCK cycles total sample time.
 *  0b11..2 extra ADCK cycles; 6 ADCK cycles total sample time.
 */
#define ADC_CFG2_ADLSTS(x)                       (((uint32_t)(((uint32_t)(x)) << ADC_CFG2_ADLSTS_SHIFT)) & ADC_CFG2_ADLSTS_MASK)

#define ADC_CFG2_ADHSC_MASK                      (0x4U)
#define ADC_CFG2_ADHSC_SHIFT                     (2U)
/*! ADHSC - High-Speed Configuration
 *  0b0..Normal conversion sequence selected.
 *  0b1..High-speed conversion sequence selected with 2 additional ADCK cycles to total conversion time.
 */
#define ADC_CFG2_ADHSC(x)                        (((uint32_t)(((uint32_t)(x)) << ADC_CFG2_ADHSC_SHIFT)) & ADC_CFG2_ADHSC_MASK)

#define ADC_CFG2_ADACKEN_MASK                    (0x8U)
#define ADC_CFG2_ADACKEN_SHIFT                   (3U)
/*! ADACKEN - Asynchronous Clock Output Enable
 *  0b0..Asynchronous clock output disabled; Asynchronous clock is enabled only if selected by ADICLK and a conversion is active.
 *  0b1..Asynchronous clock and clock output is enabled regardless of the state of the ADC.
 */
#define ADC_CFG2_ADACKEN(x)                      (((uint32_t)(((uint32_t)(x)) << ADC_CFG2_ADACKEN_SHIFT)) & ADC_CFG2_ADACKEN_MASK)

#define ADC_CFG2_MUXSEL_MASK                     (0x10U)
#define ADC_CFG2_MUXSEL_SHIFT                    (4U)
/*! MUXSEL - ADC Mux Select
 *  0b0..ADxxa channels are selected.
 *  0b1..ADxxb channels are selected.
 */
#define ADC_CFG2_MUXSEL(x)                       (((uint32_t)(((uint32_t)(x)) << ADC_CFG2_MUXSEL_SHIFT)) & ADC_CFG2_MUXSEL_MASK)
/*! @} */

/*! @name R - ADC Data Result Register */
/*! @{ */

#define ADC_R_D_MASK                             (0xFFFFU)
#define ADC_R_D_SHIFT                            (0U)
/*! D - Data result */
#define ADC_R_D(x)                               (((uint32_t)(((uint32_t)(x)) << ADC_R_D_SHIFT)) & ADC_R_D_MASK)
/*! @} */

/*! @name CV1 - Compare Value Registers */
/*! @{ */

#define ADC_CV1_CV_MASK                          (0xFFFFU)
#define ADC_CV1_CV_SHIFT                         (0U)
/*! CV - Compare Value. */
#define ADC_CV1_CV(x)                            (((uint32_t)(((uint32_t)(x)) << ADC_CV1_CV_SHIFT)) & ADC_CV1_CV_MASK)
/*! @} */

/*! @name CV2 - Compare Value Registers */
/*! @{ */

#define ADC_CV2_CV_MASK                          (0xFFFFU)
#define ADC_CV2_CV_SHIFT                         (0U)
/*! CV - Compare Value. */
#define ADC_CV2_CV(x)                            (((uint32_t)(((uint32_t)(x)) << ADC_CV2_CV_SHIFT)) & ADC_CV2_CV_MASK)
/*! @} */

/*! @name SC2 - Status and Control Register 2 */
/*! @{ */

#define ADC_SC2_REFSEL_MASK                      (0x3U)
#define ADC_SC2_REFSEL_SHIFT                     (0U)
/*! REFSEL - Voltage Reference Selection
 *  0b00..Default voltage reference pin pair, that is, external pins VREFH and VREFL
 *  0b01..Alternate reference pair, that is, VALTH and VALTL . This pair may be additional external pins or
 *        internal sources depending on the MCU configuration. See the chip configuration information for details
 *        specific to this MCU
 *  0b10..Reserved
 *  0b11..Reserved
 */
#define ADC_SC2_REFSEL(x)                        (((uint32_t)(((uint32_t)(x)) << ADC_SC2_REFSEL_SHIFT)) & ADC_SC2_REFSEL_MASK)

#define ADC_SC2_DMAEN_MASK                       (0x4U)
#define ADC_SC2_DMAEN_SHIFT                      (2U)
/*! DMAEN - DMA Enable
 *  0b0..DMA is disabled.
 *  0b1..DMA is enabled and will assert the ADC DMA request during an ADC conversion complete event noted when any
 *       of the SC1n[COCO] flags is asserted.
 */
#define ADC_SC2_DMAEN(x)                         (((uint32_t)(((uint32_t)(x)) << ADC_SC2_DMAEN_SHIFT)) & ADC_SC2_DMAEN_MASK)

#define ADC_SC2_ACREN_MASK                       (0x8U)
#define ADC_SC2_ACREN_SHIFT                      (3U)
/*! ACREN - Compare Function Range Enable
 *  0b0..Range function disabled. Only CV1 is compared.
 *  0b1..Range function enabled. Both CV1 and CV2 are compared.
 */
#define ADC_SC2_ACREN(x)                         (((uint32_t)(((uint32_t)(x)) << ADC_SC2_ACREN_SHIFT)) & ADC_SC2_ACREN_MASK)

#define ADC_SC2_ACFGT_MASK                       (0x10U)
#define ADC_SC2_ACFGT_SHIFT                      (4U)
/*! ACFGT - Compare Function Greater Than Enable
 *  0b0..Configures less than threshold, outside range not inclusive and inside range not inclusive; functionality
 *       based on the values placed in CV1 and CV2.
 *  0b1..Configures greater than or equal to threshold, outside and inside ranges inclusive; functionality based on the values placed in CV1 and CV2.
 */
#define ADC_SC2_ACFGT(x)                         (((uint32_t)(((uint32_t)(x)) << ADC_SC2_ACFGT_SHIFT)) & ADC_SC2_ACFGT_MASK)

#define ADC_SC2_ACFE_MASK                        (0x20U)
#define ADC_SC2_ACFE_SHIFT                       (5U)
/*! ACFE - Compare Function Enable
 *  0b0..Compare function disabled.
 *  0b1..Compare function enabled.
 */
#define ADC_SC2_ACFE(x)                          (((uint32_t)(((uint32_t)(x)) << ADC_SC2_ACFE_SHIFT)) & ADC_SC2_ACFE_MASK)

#define ADC_SC2_ADTRG_MASK                       (0x40U)
#define ADC_SC2_ADTRG_SHIFT                      (6U)
/*! ADTRG - Conversion Trigger Select
 *  0b0..Software trigger selected.
 *  0b1..Hardware trigger selected.
 */
#define ADC_SC2_ADTRG(x)                         (((uint32_t)(((uint32_t)(x)) << ADC_SC2_ADTRG_SHIFT)) & ADC_SC2_ADTRG_MASK)

#define ADC_SC2_ADACT_MASK                       (0x80U)
#define ADC_SC2_ADACT_SHIFT                      (7U)
/*! ADACT - Conversion Active
 *  0b0..Conversion not in progress.
 *  0b1..Conversion in progress.
 */
#define ADC_SC2_ADACT(x)                         (((uint32_t)(((uint32_t)(x)) << ADC_SC2_ADACT_SHIFT)) & ADC_SC2_ADACT_MASK)
/*! @} */

/*! @name SC3 - Status and Control Register 3 */
/*! @{ */

#define ADC_SC3_AVGS_MASK                        (0x3U)
#define ADC_SC3_AVGS_SHIFT                       (0U)
/*! AVGS - Hardware Average Select
 *  0b00..4 samples averaged.
 *  0b01..8 samples averaged.
 *  0b10..16 samples averaged.
 *  0b11..32 samples averaged.
 */
#define ADC_SC3_AVGS(x)                          (((uint32_t)(((uint32_t)(x)) << ADC_SC3_AVGS_SHIFT)) & ADC_SC3_AVGS_MASK)

#define ADC_SC3_AVGE_MASK                        (0x4U)
#define ADC_SC3_AVGE_SHIFT                       (2U)
/*! AVGE - Hardware Average Enable
 *  0b0..Hardware average function disabled.
 *  0b1..Hardware average function enabled.
 */
#define ADC_SC3_AVGE(x)                          (((uint32_t)(((uint32_t)(x)) << ADC_SC3_AVGE_SHIFT)) & ADC_SC3_AVGE_MASK)

#define ADC_SC3_ADCO_MASK                        (0x8U)
#define ADC_SC3_ADCO_SHIFT                       (3U)
/*! ADCO - Continuous Conversion Enable
 *  0b0..One conversion or one set of conversions if the hardware average function is enabled, that is, AVGE=1, after initiating a conversion.
 *  0b1..Continuous conversions or sets of conversions if the hardware average function is enabled, that is, AVGE=1, after initiating a conversion.
 */
#define ADC_SC3_ADCO(x)                          (((uint32_t)(((uint32_t)(x)) << ADC_SC3_ADCO_SHIFT)) & ADC_SC3_ADCO_MASK)

#define ADC_SC3_CALF_MASK                        (0x40U)
#define ADC_SC3_CALF_SHIFT                       (6U)
/*! CALF - Calibration Failed Flag
 *  0b0..Calibration completed normally.
 *  0b1..Calibration failed. ADC accuracy specifications are not guaranteed.
 */
#define ADC_SC3_CALF(x)                          (((uint32_t)(((uint32_t)(x)) << ADC_SC3_CALF_SHIFT)) & ADC_SC3_CALF_MASK)

#define ADC_SC3_CAL_MASK                         (0x80U)
#define ADC_SC3_CAL_SHIFT                        (7U)
/*! CAL - Calibration */
#define ADC_SC3_CAL(x)                           (((uint32_t)(((uint32_t)(x)) << ADC_SC3_CAL_SHIFT)) & ADC_SC3_CAL_MASK)
/*! @} */

/*! @name OFS - ADC Offset Correction Register */
/*! @{ */

#define ADC_OFS_OFS_MASK                         (0xFFFFU)
#define ADC_OFS_OFS_SHIFT                        (0U)
/*! OFS - Offset Error Correction Value */
#define ADC_OFS_OFS(x)                           (((uint32_t)(((uint32_t)(x)) << ADC_OFS_OFS_SHIFT)) & ADC_OFS_OFS_MASK)
/*! @} */

/*! @name PG - ADC Plus-Side Gain Register */
/*! @{ */

#define ADC_PG_PG_MASK                           (0xFFFFU)
#define ADC_PG_PG_SHIFT                          (0U)
/*! PG - Plus-Side Gain */
#define ADC_PG_PG(x)                             (((uint32_t)(((uint32_t)(x)) << ADC_PG_PG_SHIFT)) & ADC_PG_PG_MASK)
/*! @} */

/*! @name MG - ADC Minus-Side Gain Register */
/*! @{ */

#define ADC_MG_MG_MASK                           (0xFFFFU)
#define ADC_MG_MG_SHIFT                          (0U)
/*! MG - Minus-Side Gain */
#define ADC_MG_MG(x)                             (((uint32_t)(((uint32_t)(x)) << ADC_MG_MG_SHIFT)) & ADC_MG_MG_MASK)
/*! @} */

/*! @name CLPD - ADC Plus-Side General Calibration Value Register */
/*! @{ */

#define ADC_CLPD_CLPD_MASK                       (0x3FU)
#define ADC_CLPD_CLPD_SHIFT                      (0U)
/*! CLPD - Calibration Value */
#define ADC_CLPD_CLPD(x)                         (((uint32_t)(((uint32_t)(x)) << ADC_CLPD_CLPD_SHIFT)) & ADC_CLPD_CLPD_MASK)
/*! @} */

/*! @name CLPS - ADC Plus-Side General Calibration Value Register */
/*! @{ */

#define ADC_CLPS_CLPS_MASK                       (0x3FU)
#define ADC_CLPS_CLPS_SHIFT                      (0U)
/*! CLPS - Calibration Value */
#define ADC_CLPS_CLPS(x)                         (((uint32_t)(((uint32_t)(x)) << ADC_CLPS_CLPS_SHIFT)) & ADC_CLPS_CLPS_MASK)
/*! @} */

/*! @name CLP4 - ADC Plus-Side General Calibration Value Register */
/*! @{ */

#define ADC_CLP4_CLP4_MASK                       (0x3FFU)
#define ADC_CLP4_CLP4_SHIFT                      (0U)
/*! CLP4 - Calibration Value */
#define ADC_CLP4_CLP4(x)                         (((uint32_t)(((uint32_t)(x)) << ADC_CLP4_CLP4_SHIFT)) & ADC_CLP4_CLP4_MASK)
/*! @} */

/*! @name CLP3 - ADC Plus-Side General Calibration Value Register */
/*! @{ */

#define ADC_CLP3_CLP3_MASK                       (0x1FFU)
#define ADC_CLP3_CLP3_SHIFT                      (0U)
/*! CLP3 - Calibration Value */
#define ADC_CLP3_CLP3(x)                         (((uint32_t)(((uint32_t)(x)) << ADC_CLP3_CLP3_SHIFT)) & ADC_CLP3_CLP3_MASK)
/*! @} */

/*! @name CLP2 - ADC Plus-Side General Calibration Value Register */
/*! @{ */

#define ADC_CLP2_CLP2_MASK                       (0xFFU)
#define ADC_CLP2_CLP2_SHIFT                      (0U)
/*! CLP2 - Calibration Value */
#define ADC_CLP2_CLP2(x)                         (((uint32_t)(((uint32_t)(x)) << ADC_CLP2_CLP2_SHIFT)) & ADC_CLP2_CLP2_MASK)
/*! @} */

/*! @name CLP1 - ADC Plus-Side General Calibration Value Register */
/*! @{ */

#define ADC_CLP1_CLP1_MASK                       (0x7FU)
#define ADC_CLP1_CLP1_SHIFT                      (0U)
/*! CLP1 - Calibration Value */
#define ADC_CLP1_CLP1(x)                         (((uint32_t)(((uint32_t)(x)) << ADC_CLP1_CLP1_SHIFT)) & ADC_CLP1_CLP1_MASK)
/*! @} */

/*! @name CLP0 - ADC Plus-Side General Calibration Value Register */
/*! @{ */

#define ADC_CLP0_CLP0_MASK                       (0x3FU)
#define ADC_CLP0_CLP0_SHIFT                      (0U)
/*! CLP0 - Calibration Value */
#define ADC_CLP0_CLP0(x)                         (((uint32_t)(((uint32_t)(x)) << ADC_CLP0_CLP0_SHIFT)) & ADC_CLP0_CLP0_MASK)
/*! @} */

/*! @name CLMD - ADC Minus-Side General Calibration Value Register */
/*! @{ */

#define ADC_CLMD_CLMD_MASK                       (0x3FU)
#define ADC_CLMD_CLMD_SHIFT                      (0U)
/*! CLMD - Calibration Value */
#define ADC_CLMD_CLMD(x)                         (((uint32_t)(((uint32_t)(x)) << ADC_CLMD_CLMD_SHIFT)) & ADC_CLMD_CLMD_MASK)
/*! @} */

/*! @name CLMS - ADC Minus-Side General Calibration Value Register */
/*! @{ */

#define ADC_CLMS_CLMS_MASK                       (0x3FU)
#define ADC_CLMS_CLMS_SHIFT                      (0U)
/*! CLMS - Calibration Value */
#define ADC_CLMS_CLMS(x)                         (((uint32_t)(((uint32_t)(x)) << ADC_CLMS_CLMS_SHIFT)) & ADC_CLMS_CLMS_MASK)
/*! @} */

/*! @name CLM4 - ADC Minus-Side General Calibration Value Register */
/*! @{ */

#define ADC_CLM4_CLM4_MASK                       (0x3FFU)
#define ADC_CLM4_CLM4_SHIFT                      (0U)
/*! CLM4 - Calibration Value */
#define ADC_CLM4_CLM4(x)                         (((uint32_t)(((uint32_t)(x)) << ADC_CLM4_CLM4_SHIFT)) & ADC_CLM4_CLM4_MASK)
/*! @} */

/*! @name CLM3 - ADC Minus-Side General Calibration Value Register */
/*! @{ */

#define ADC_CLM3_CLM3_MASK                       (0x1FFU)
#define ADC_CLM3_CLM3_SHIFT                      (0U)
/*! CLM3 - Calibration Value */
#define ADC_CLM3_CLM3(x)                         (((uint32_t)(((uint32_t)(x)) << ADC_CLM3_CLM3_SHIFT)) & ADC_CLM3_CLM3_MASK)
/*! @} */

/*! @name CLM2 - ADC Minus-Side General Calibration Value Register */
/*! @{ */

#define ADC_CLM2_CLM2_MASK                       (0xFFU)
#define ADC_CLM2_CLM2_SHIFT                      (0U)
/*! CLM2 - Calibration Value */
#define ADC_CLM2_CLM2(x)                         (((uint32_t)(((uint32_t)(x)) << ADC_CLM2_CLM2_SHIFT)) & ADC_CLM2_CLM2_MASK)
/*! @} */

/*! @name CLM1 - ADC Minus-Side General Calibration Value Register */
/*! @{ */

#define ADC_CLM1_CLM1_MASK                       (0x7FU)
#define ADC_CLM1_CLM1_SHIFT                      (0U)
/*! CLM1 - Calibration Value */
#define ADC_CLM1_CLM1(x)                         (((uint32_t)(((uint32_t)(x)) << ADC_CLM1_CLM1_SHIFT)) & ADC_CLM1_CLM1_MASK)
/*! @} */

/*! @name CLM0 - ADC Minus-Side General Calibration Value Register */
/*! @{ */

#define ADC_CLM0_CLM0_MASK                       (0x3FU)
#define ADC_CLM0_CLM0_SHIFT                      (0U)
/*! CLM0 - Calibration Value */
#define ADC_CLM0_CLM0(x)                         (((uint32_t)(((uint32_t)(x)) << ADC_CLM0_CLM0_SHIFT)) & ADC_CLM0_CLM0_MASK)
/*! @} */


/*!
 * @}
 */ /* end of group ADC_Register_Masks */


/*!
 * @}
 */ /* end of group ADC_Peripheral_Access_Layer */


/*
** End of section using anonymous unions
*/

#if defined(__ARMCC_VERSION)
  #if (__ARMCC_VERSION >= 6010050)
    #pragma clang diagnostic pop
  #else
    #pragma pop
  #endif
#elif defined(__CWCC__)
  #pragma pop
#elif defined(__GNUC__)
  /* leave anonymous unions enabled */
#elif defined(__IAR_SYSTEMS_ICC__)
  #pragma language=default
#else
  #error Not supported compiler type
#endif

/*!
 * @}
 */ /* end of group Peripheral_access_layer */


#endif  /* ADC_H_ */
