vojt444/picoballoon/SW/picoballoon_v1/MCXC242_Project/device/periph1/PERI_I2C.h

/*
** ###################################################################
**     Processors:          MCXC141VFM
**                          MCXC141VLH
**                          MCXC142VFM
**                          MCXC242VFM
**                          MCXC242VLH
**
**     Version:             rev. 1.6, 2016-06-24
**     Build:               b240705
**
**     Abstract:
**         CMSIS Peripheral Access Layer for I2C
**
**     Copyright 1997-2016 Freescale Semiconductor, Inc.
**     Copyright 2016-2024 NXP
**     SPDX-License-Identifier: BSD-3-Clause
**
**     http:                 www.nxp.com
**     mail:                 support@nxp.com
**
**     Revisions:
**     - rev. 1.0 (2014-05-12)
**         Initial version.
**     - rev. 1.1 (2014-07-10)
**         UART0 - UART0 module renamed to UART2.
**     - rev. 1.2 (2014-08-12)
**         CRC - CRC register renamed to DATA.
**     - rev. 1.3 (2014-09-02)
**         USB - USB0_CTL0 was renamed to USB0_OTGCTL register.
**         USB - USB0_CTL1 was renamed to USB0_CTL register.
**         USB - Two new bitfields (STOP_ACK_DLY_EN, AHB_DLY_EN) was added to the USB0_KEEP_ALIVE_CTRL register.
**     - rev. 1.4 (2014-09-22)
**         FLEXIO - Offsets of the SHIFTBUFBIS registers were interchanged with offsets of the SHIFTBUFBBS registers.
**         SIM - Changed bitfield value MCGIRCLK to LIRC_CLK of bitfield CLKOUTSEL in SOPT2 register.
**         SIM - Removed bitfield DIEID in SDID register.
**         UART2 - Removed ED register.
**         UART2 - Removed MODEM register.
**         UART2 - Removed IR register.
**         UART2 - Removed PFIFO register.
**         UART2 - Removed CFIFO register.
**         UART2 - Removed SFIFO register.
**         UART2 - Removed TWFIFO register.
**         UART2 - Removed TCFIFO register.
**         UART2 - Removed RWFIFO register.
**         UART2 - Removed RCFIFO register.
**         USB - Removed bitfield REG_EN in CLK_RECOVER_IRC_EN register.
**         USB - Renamed USBEN bitfield of USB0_CTL was renamed to USBENSOFEN.
**     - rev. 1.5 (2016-02-02)
**         FGPIO - Add FGPIO registers.
**     - rev. 1.6 (2016-06-24)
**         USB - OTGCTL register was removed.
**         USB - Bit RESUME was added in CTL register.
**
** ###################################################################
*/

/*!
 * @file I2C.h
 * @version 1.6
 * @date 2016-06-24
 * @brief CMSIS Peripheral Access Layer for I2C
 *
 * CMSIS Peripheral Access Layer for I2C
 */

#if !defined(I2C_H_)
#define I2C_H_                                   /**< Symbol preventing repeated inclusion */

#if (defined(CPU_MCXC141VFM) || defined(CPU_MCXC141VLH))
#include "MCXC141_COMMON.h"
#elif (defined(CPU_MCXC142VFM))
#include "MCXC142_COMMON.h"
#elif (defined(CPU_MCXC242VFM) || defined(CPU_MCXC242VLH))
#include "MCXC242_COMMON.h"
#else
  #error "No valid CPU defined!"
#endif

/* ----------------------------------------------------------------------------
   -- Device Peripheral Access Layer
   ---------------------------------------------------------------------------- */

/*!
 * @addtogroup Peripheral_access_layer Device Peripheral Access Layer
 * @{
 */


/*
** Start of section using anonymous unions
*/

#if defined(__ARMCC_VERSION)
  #if (__ARMCC_VERSION >= 6010050)
    #pragma clang diagnostic push
  #else
    #pragma push
    #pragma anon_unions
  #endif
#elif defined(__CWCC__)
  #pragma push
  #pragma cpp_extensions on
#elif defined(__GNUC__)
  /* anonymous unions are enabled by default */
#elif defined(__IAR_SYSTEMS_ICC__)
  #pragma language=extended
#else
  #error Not supported compiler type
#endif

/* ----------------------------------------------------------------------------
   -- I2C Peripheral Access Layer
   ---------------------------------------------------------------------------- */

/*!
 * @addtogroup I2C_Peripheral_Access_Layer I2C Peripheral Access Layer
 * @{
 */

/** I2C - Register Layout Typedef */
typedef struct {
  __IO uint8_t A1;                                 /**< I2C Address Register 1, offset: 0x0 */
  __IO uint8_t F;                                  /**< I2C Frequency Divider register, offset: 0x1 */
  __IO uint8_t C1;                                 /**< I2C Control Register 1, offset: 0x2 */
  __IO uint8_t S;                                  /**< I2C Status register, offset: 0x3 */
  __IO uint8_t D;                                  /**< I2C Data I/O register, offset: 0x4 */
  __IO uint8_t C2;                                 /**< I2C Control Register 2, offset: 0x5 */
  __IO uint8_t FLT;                                /**< I2C Programmable Input Glitch Filter Register, offset: 0x6 */
  __IO uint8_t RA;                                 /**< I2C Range Address register, offset: 0x7 */
  __IO uint8_t SMB;                                /**< I2C SMBus Control and Status register, offset: 0x8 */
  __IO uint8_t A2;                                 /**< I2C Address Register 2, offset: 0x9 */
  __IO uint8_t SLTH;                               /**< I2C SCL Low Timeout Register High, offset: 0xA */
  __IO uint8_t SLTL;                               /**< I2C SCL Low Timeout Register Low, offset: 0xB */
  __IO uint8_t S2;                                 /**< I2C Status register 2, offset: 0xC */
} I2C_Type;

/* ----------------------------------------------------------------------------
   -- I2C Register Masks
   ---------------------------------------------------------------------------- */

/*!
 * @addtogroup I2C_Register_Masks I2C Register Masks
 * @{
 */

/*! @name A1 - I2C Address Register 1 */
/*! @{ */

#define I2C_A1_AD_MASK                           (0xFEU)
#define I2C_A1_AD_SHIFT                          (1U)
/*! AD - Address */
#define I2C_A1_AD(x)                             (((uint8_t)(((uint8_t)(x)) << I2C_A1_AD_SHIFT)) & I2C_A1_AD_MASK)
/*! @} */

/*! @name F - I2C Frequency Divider register */
/*! @{ */

#define I2C_F_ICR_MASK                           (0x3FU)
#define I2C_F_ICR_SHIFT                          (0U)
/*! ICR - ClockRate */
#define I2C_F_ICR(x)                             (((uint8_t)(((uint8_t)(x)) << I2C_F_ICR_SHIFT)) & I2C_F_ICR_MASK)

#define I2C_F_MULT_MASK                          (0xC0U)
#define I2C_F_MULT_SHIFT                         (6U)
/*! MULT - Multiplier Factor
 *  0b00..mul = 1
 *  0b01..mul = 2
 *  0b10..mul = 4
 *  0b11..Reserved
 */
#define I2C_F_MULT(x)                            (((uint8_t)(((uint8_t)(x)) << I2C_F_MULT_SHIFT)) & I2C_F_MULT_MASK)
/*! @} */

/*! @name C1 - I2C Control Register 1 */
/*! @{ */

#define I2C_C1_DMAEN_MASK                        (0x1U)
#define I2C_C1_DMAEN_SHIFT                       (0U)
/*! DMAEN - DMA Enable
 *  0b0..All DMA signalling disabled.
 *  0b1..DMA transfer is enabled. While SMB[FACK] = 0, the following conditions trigger the DMA request: a data
 *       byte is received, and either address or data is transmitted. (ACK/NACK is automatic) the first byte received
 *       matches the A1 register or is a general call address. If any address matching occurs, S[IAAS] and S[TCF]
 *       are set. If the direction of transfer is known from master to slave, then it is not required to check
 *       S[SRW]. With this assumption, DMA can also be used in this case. In other cases, if the master reads data from
 *       the slave, then it is required to rewrite the C1 register operation. With this assumption, DMA cannot be
 *       used. When FACK = 1, an address or a data byte is transmitted.
 */
#define I2C_C1_DMAEN(x)                          (((uint8_t)(((uint8_t)(x)) << I2C_C1_DMAEN_SHIFT)) & I2C_C1_DMAEN_MASK)

#define I2C_C1_WUEN_MASK                         (0x2U)
#define I2C_C1_WUEN_SHIFT                        (1U)
/*! WUEN - Wakeup Enable
 *  0b0..Normal operation. No interrupt generated when address matching in low power mode.
 *  0b1..Enables the wakeup function in low power mode.
 */
#define I2C_C1_WUEN(x)                           (((uint8_t)(((uint8_t)(x)) << I2C_C1_WUEN_SHIFT)) & I2C_C1_WUEN_MASK)

#define I2C_C1_RSTA_MASK                         (0x4U)
#define I2C_C1_RSTA_SHIFT                        (2U)
/*! RSTA - Repeat START */
#define I2C_C1_RSTA(x)                           (((uint8_t)(((uint8_t)(x)) << I2C_C1_RSTA_SHIFT)) & I2C_C1_RSTA_MASK)

#define I2C_C1_TXAK_MASK                         (0x8U)
#define I2C_C1_TXAK_SHIFT                        (3U)
/*! TXAK - Transmit Acknowledge Enable
 *  0b0..An acknowledge signal is sent to the bus on the following receiving byte (if FACK is cleared) or the
 *       current receiving byte (if FACK is set).
 *  0b1..No acknowledge signal is sent to the bus on the following receiving data byte (if FACK is cleared) or the
 *       current receiving data byte (if FACK is set).
 */
#define I2C_C1_TXAK(x)                           (((uint8_t)(((uint8_t)(x)) << I2C_C1_TXAK_SHIFT)) & I2C_C1_TXAK_MASK)

#define I2C_C1_TX_MASK                           (0x10U)
#define I2C_C1_TX_SHIFT                          (4U)
/*! TX - Transmit Mode Select
 *  0b0..Receive
 *  0b1..Transmit
 */
#define I2C_C1_TX(x)                             (((uint8_t)(((uint8_t)(x)) << I2C_C1_TX_SHIFT)) & I2C_C1_TX_MASK)

#define I2C_C1_MST_MASK                          (0x20U)
#define I2C_C1_MST_SHIFT                         (5U)
/*! MST - Master Mode Select
 *  0b0..Slave mode
 *  0b1..Master mode
 */
#define I2C_C1_MST(x)                            (((uint8_t)(((uint8_t)(x)) << I2C_C1_MST_SHIFT)) & I2C_C1_MST_MASK)

#define I2C_C1_IICIE_MASK                        (0x40U)
#define I2C_C1_IICIE_SHIFT                       (6U)
/*! IICIE - I2C Interrupt Enable
 *  0b0..Disabled
 *  0b1..Enabled
 */
#define I2C_C1_IICIE(x)                          (((uint8_t)(((uint8_t)(x)) << I2C_C1_IICIE_SHIFT)) & I2C_C1_IICIE_MASK)

#define I2C_C1_IICEN_MASK                        (0x80U)
#define I2C_C1_IICEN_SHIFT                       (7U)
/*! IICEN - I2C Enable
 *  0b0..Disabled
 *  0b1..Enabled
 */
#define I2C_C1_IICEN(x)                          (((uint8_t)(((uint8_t)(x)) << I2C_C1_IICEN_SHIFT)) & I2C_C1_IICEN_MASK)
/*! @} */

/*! @name S - I2C Status register */
/*! @{ */

#define I2C_S_RXAK_MASK                          (0x1U)
#define I2C_S_RXAK_SHIFT                         (0U)
/*! RXAK - Receive Acknowledge
 *  0b0..Acknowledge signal was received after the completion of one byte of data transmission on the bus
 *  0b1..No acknowledge signal detected
 */
#define I2C_S_RXAK(x)                            (((uint8_t)(((uint8_t)(x)) << I2C_S_RXAK_SHIFT)) & I2C_S_RXAK_MASK)

#define I2C_S_IICIF_MASK                         (0x2U)
#define I2C_S_IICIF_SHIFT                        (1U)
/*! IICIF - Interrupt Flag
 *  0b0..No interrupt pending
 *  0b1..Interrupt pending
 */
#define I2C_S_IICIF(x)                           (((uint8_t)(((uint8_t)(x)) << I2C_S_IICIF_SHIFT)) & I2C_S_IICIF_MASK)

#define I2C_S_SRW_MASK                           (0x4U)
#define I2C_S_SRW_SHIFT                          (2U)
/*! SRW - Slave Read/Write
 *  0b0..Slave receive, master writing to slave
 *  0b1..Slave transmit, master reading from slave
 */
#define I2C_S_SRW(x)                             (((uint8_t)(((uint8_t)(x)) << I2C_S_SRW_SHIFT)) & I2C_S_SRW_MASK)

#define I2C_S_RAM_MASK                           (0x8U)
#define I2C_S_RAM_SHIFT                          (3U)
/*! RAM - Range Address Match
 *  0b0..Not addressed
 *  0b1..Addressed as a slave
 */
#define I2C_S_RAM(x)                             (((uint8_t)(((uint8_t)(x)) << I2C_S_RAM_SHIFT)) & I2C_S_RAM_MASK)

#define I2C_S_ARBL_MASK                          (0x10U)
#define I2C_S_ARBL_SHIFT                         (4U)
/*! ARBL - Arbitration Lost
 *  0b0..Standard bus operation.
 *  0b1..Loss of arbitration.
 */
#define I2C_S_ARBL(x)                            (((uint8_t)(((uint8_t)(x)) << I2C_S_ARBL_SHIFT)) & I2C_S_ARBL_MASK)

#define I2C_S_BUSY_MASK                          (0x20U)
#define I2C_S_BUSY_SHIFT                         (5U)
/*! BUSY - Bus Busy
 *  0b0..Bus is idle
 *  0b1..Bus is busy
 */
#define I2C_S_BUSY(x)                            (((uint8_t)(((uint8_t)(x)) << I2C_S_BUSY_SHIFT)) & I2C_S_BUSY_MASK)

#define I2C_S_IAAS_MASK                          (0x40U)
#define I2C_S_IAAS_SHIFT                         (6U)
/*! IAAS - Addressed As A Slave
 *  0b0..Not addressed
 *  0b1..Addressed as a slave
 */
#define I2C_S_IAAS(x)                            (((uint8_t)(((uint8_t)(x)) << I2C_S_IAAS_SHIFT)) & I2C_S_IAAS_MASK)

#define I2C_S_TCF_MASK                           (0x80U)
#define I2C_S_TCF_SHIFT                          (7U)
/*! TCF - Transfer Complete Flag
 *  0b0..Transfer in progress
 *  0b1..Transfer complete
 */
#define I2C_S_TCF(x)                             (((uint8_t)(((uint8_t)(x)) << I2C_S_TCF_SHIFT)) & I2C_S_TCF_MASK)
/*! @} */

/*! @name D - I2C Data I/O register */
/*! @{ */

#define I2C_D_DATA_MASK                          (0xFFU)
#define I2C_D_DATA_SHIFT                         (0U)
/*! DATA - Data */
#define I2C_D_DATA(x)                            (((uint8_t)(((uint8_t)(x)) << I2C_D_DATA_SHIFT)) & I2C_D_DATA_MASK)
/*! @} */

/*! @name C2 - I2C Control Register 2 */
/*! @{ */

#define I2C_C2_AD_MASK                           (0x7U)
#define I2C_C2_AD_SHIFT                          (0U)
/*! AD - Slave Address */
#define I2C_C2_AD(x)                             (((uint8_t)(((uint8_t)(x)) << I2C_C2_AD_SHIFT)) & I2C_C2_AD_MASK)

#define I2C_C2_RMEN_MASK                         (0x8U)
#define I2C_C2_RMEN_SHIFT                        (3U)
/*! RMEN - Range Address Matching Enable
 *  0b0..Range mode disabled. No address matching occurs for an address within the range of values of the A1 and RA registers.
 *  0b1..Range mode enabled. Address matching occurs when a slave receives an address within the range of values of the A1 and RA registers.
 */
#define I2C_C2_RMEN(x)                           (((uint8_t)(((uint8_t)(x)) << I2C_C2_RMEN_SHIFT)) & I2C_C2_RMEN_MASK)

#define I2C_C2_SBRC_MASK                         (0x10U)
#define I2C_C2_SBRC_SHIFT                        (4U)
/*! SBRC - Slave Baud Rate Control
 *  0b0..The slave baud rate follows the master baud rate and clock stretching may occur
 *  0b1..Slave baud rate is independent of the master baud rate
 */
#define I2C_C2_SBRC(x)                           (((uint8_t)(((uint8_t)(x)) << I2C_C2_SBRC_SHIFT)) & I2C_C2_SBRC_MASK)
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
