vojt444/picoballoon/(commit log)

2024-10-15 kicad project
    [GNSS.kicad_sch, communication.kicad_sch, picoballoon.kicad_pcb, picoballoon.kicad_sch, power.kicad_sch, sensors.kicad_sch]
2024-10-15 impedance matching
    [communication.kicad_sch]
2024-10-17 aprs test board
    [GNSS.kicad_sch, aprs_test_board.kicad_pcb, aprs_test_board.kicad_sch, communication.kicad_sch, picoballoon.kicad_pcb, picoballoon.kicad_sch, power.kicad_sch, sensors.kicad_sch]
2024-10-19 APRS test board done
    [aprs_test_board.kicad_pcb, aprs_test_board.kicad_sch]
2024-10-20 test board
    [aprs_test_board-B_Cu.gbr, aprs_test_board-B_Mask.gbr, aprs_test_board-B_Paste.gbr, aprs_test_board-B_Silkscreen.gbr, aprs_test_board-Edge_Cuts.gbr, aprs_test_board-F_Cu.gbr, aprs_test_board-F_Mask.gbr, aprs_test_board-F_Paste.gbr]
2024-10-23 gerber files
    [aprs_test_board-B_Cu.gbr, aprs_test_board-B_Mask.gbr, aprs_test_board-B_Paste.gbr, aprs_test_board-B_Silkscreen.gbr, aprs_test_board-Edge_Cuts.gbr, aprs_test_board-F_Cu.gbr, aprs_test_board-F_Mask.gbr, aprs_test_board-F_Paste.gbr]
2024-10-23 little fix
    [aprs_test_board-B_Cu.gbr, aprs_test_board-B_Mask.gbr, aprs_test_board-B_Paste.gbr, aprs_test_board-B_Silkscreen.gbr, aprs_test_board-Edge_Cuts.gbr, aprs_test_board-F_Cu.gbr, aprs_test_board-F_Mask.gbr, aprs_test_board-F_Paste.gbr]
2024-10-23 sharp angles fix
    [aprs_test_board.kicad_pcb]
2024-10-30 some devices replaced
    [GNSS.kicad_sch, picoballoon.kicad_sch, sensors.kicad_sch]
2024-11-11 aprs test board fixed
2024-12-13 picoballoon pcb
    [GNSS.kicad_sch, RECE.20369.001E.01.stp, communication.kicad_sch, picoballoon.kicad_pcb, picoballoon.kicad_sch, power.kicad_sch]
2024-12-13 minor fixes
    [picoballoon.kicad_pcb]
2024-12-14 test points
    [picoballoon.kicad_pcb, picoballoon.kicad_sch, power.kicad_sch]
2024-12-28 gnss antenna
    [picoballoon.kicad_pcb]
2024-12-28 mounting holes
    [picoballoon-B_GND.gbr, picoballoon-B_Mask.gbr, picoballoon-B_Paste.gbr, picoballoon-B_Silkscreen.gbr, picoballoon-Edge_Cuts.gbr, picoballoon-F_Mask.gbr, picoballoon-F_Paste.gbr, picoballoon-F_Signal.gbr]
2024-12-28 old PCB rename
    [picoballoon_OLD.kicad_pcb]
2024-12-28 power supply change
    [picoballoon.kicad_pcb, power.kicad_sch]
2024-12-28 little changes
    [picoballoon.kicad_pcb, picoballoon.kicad_sch]
2024-12-29 test board 3D
    [aprs_test_board.kicad_pcb]
2025-02-13 APRS testing with Arduinno
    [GNSS.kicad_sch, aprs_test_board.kicad_pcb, aprs_test_board.kicad_sch, communication.kicad_sch, picoballoon.kicad_pcb, picoballoon.kicad_sch, power.kicad_sch, sensors.kicad_sch]
2025-02-17 test FW, not working yet
    [arduino_test2.ino, test3.ino]
2025-03-23 FW for temp sensor and ADC
2025-03-24 c file moved to the correct folder
    [MCP9802.c]
2025-03-28 SPI is working :)
2025-04-10 PCB v2 starting
    [BLM21AG601SH1D.stp, GNSS.kicad_sch, HTU21D.stp, MAX-M10M-00B.stp, MPL3115A2ST1.stp, RECE.20369.001E.01.stp, Si4461-C2A-GMR.stp, TPS61097A-33DBVR.stp]
2025-04-10 little changes in scheme
    [GNSS.kicad_sch, communication.kicad_sch, picoballoon.kicad_sch]
2025-04-12 PCB v2
    [CONMHF1-SMD-G-T.stp, GNSS.kicad_sch, SQ2337CES-T1_GE3.stp, communication.kicad_sch, picoballoon.kicad_pcb, picoballoon.kicad_sch, power.kicad_sch, sensors.kicad_sch]
2025-04-12 minor changes
    [picoballoon.kicad_pcb]
2025-04-12 GND fix
    [picoballoon.kicad_pcb]
